66wyx/yuntong-roadshow/hardware/display-hy-a354tu102gg/README.md

# HY-A354TU102GG · 云瞳手持项目选定屏幕

更新：2026-11-03。状态：**用户已选定料号，结构与电气适配待验证**。本记录替代此前 AM200Q460460FLS1 和普通 3.5 英寸 320 × 480 屏的当前选型地位。

依据：用户提供的 [原始规格书](references/HY-A354TU102GG.pdf)，共 40 页。PDF 未经修改，以 Git LFS 保存。封面标记为 Preliminary、V1，修订表为 A0 / 2026-04-02；第 37 页内嵌结构图另有 2026-02-28 / Rev.02 标记。这不是已签核的最终承认书。

## 已核实的规格

| 项目 | 规格书记录 | 位置 |
|---|---|---|
| 厂家 | 深圳市华御智能电子有限公司 / Shenzhen Winfull Intelligent Electronics Co.,Ltd. | 封面 |
| 型号 | HY-A354TU102GG | 封面 |
| 尺寸 / 类型 | 3.54 英寸，AMOLED，LTPS，带 Oncell 触摸 | 第 5、15 页 |
| 分辨率 | **604 × 1024**，不是 640 × 1024 | 第 5、37 页 |
| AA 显示区 | **45.6624 × 77.4144 mm** | 第 5、37 页 |
| 像素间距 / 密度 | 75.6 μm；据此计算约 **336 ppi** | 第 5 页 / 计算 |
| 面板本体 | **47.56 ± 0.15 × 80.11 ± 0.15 mm** | 第 37 页 |
| 本体厚度 | **0.812 ± 0.15 mm**，不含保护膜 | 第 37 页 |
| 展平总包络 | 总表写 **47.56 × 118.07 × 0.812 mm**；结构图为 80.11 mm 面板 + 37.95 ± 0.5 mm 尾部 | 第 5、37 页 |
| 局部器件厚度 | 显示 FPC 器件区最大 1.45 mm；触摸器件区最大 1.05 mm | 第 37 页 |
| 圆角 | 结构图画出圆角轮廓；未标注可直接用于 CAD 的圆角半径或角部像素遮罩 | 第 37 页 |
| 显示驱动 | SD5207，COF | 第 5、37 页 |
| 触摸驱动 | CST3530；I2C 地址记为 0x5A、总线不高于 400 kHz，5 点触控依整机调试 | 第 14 页 |
| 显示接口 | **MIPI DSI**；lane 数存在冲突，不能据此释放原理图 | 第 5–7、12 页 |
| 模式 / 刷新 | Video mode；Normal 60 Hz、AOD 30 Hz | 第 13 页 |
| 亮度 | 典型 850 cd/m²，标称范围 765–935 cd/m²；以样品为准 | 第 17 页 |

## 对外观与 UI 的影响

1. **118.07 mm 不是刚性屏体高度。** 第 37 页注明 FPC 展平出货，本体高 80.11 mm。不能因此把掌上机直接拉长到 118 mm；也不能把带 COF/器件的排线任意折叠。折弯区域、半径、连接器位置、器件净空需厂家图纸与实物确认。
2. 现有 A1 的黑玻璃是 56.4 × 80.6 mm，A3 旧草案按另一块 55.5 × 84.96 mm 模组估算。新面板更窄，但 A1 玻璃高度与新面板本体只差 0.49 mm，不能当成已有装配余量。旧 82 × 86 / 82 × 90 mm 机身均只保留作比例参考；取得 FPC 折叠包络后再收敛壳体。
3. 保留用户的 CNC 铝框 / SLA 两种材质、正面可见铝边、底部 Type-C、内置 GNSS、平放雷达 / 竖持高度示意。面板圆角与机身三次贝塞尔圆角分别设计，不能相互代用。按键布局仍按最新确认记录推进，不因换屏自行新增触摸必选操作。
4. UI 改为 **604 × 1024 原生画布**。像素数约为旧 320 × 480 的 4.03 倍，但物理字号不会随分辨率自动变大；需要重新排版，不将旧界面非等比拉伸。雷达圆形保持圆形，中文字阶和线宽按毫米与实屏观察确定。
5. AMOLED 的黑底有利于显示区与黑色窗口融合，但仍有边缘结构。精确圆角 R、角部安全区和外观盖板须用厂家 DXF / STEP 与全白点亮样品核对。
6. 第 5 页写含 cover lens，但第 37 页的 0.812 mm 拆分为 POL、Encap、LTPS、泡棉铜箔，未清楚列出独立保护盖板。**不能直接把 0.812 mm 当成已含耐用外盖板的整套外观件厚度**，也不能未经确认重复叠加盖板。

## 对电气架构的影响

原 ESP32-S3 显示连接方案不能直接连接这块 MIPI DSI 面板。旧 A0 的 SPI/并口、15 pin 插座、LCD 恒流背光和 GPIO 表不适用于新屏；AMOLED 不使用该 LCD 背光电路。

**首版显示主控选全志 T113-S3，验证板选广州眺望 Core-T113-S3（S3/S4 系列手册的 134 针版本）。** 用户指定主控支持原生 4-lane MIPI DSI。核心板为 40 × 30 mm，手册表 3.2 和 §5.3.13 列出四通道显示输出及 D0–D3、CLK 差分对。实验室采用配套 T113-S-EVM 底板，通过自备适配板连接屏幕的 39 针接口。[核心板手册](https://17575419.s21i.faiusr.com/61/ABUIABA9GAAghOvnuAYovtOh7gc.pdf) · [评估套件与开发资料](https://www.talowe.com/modules/t113s.html)

适配板按核心板实际 DSI 信号核对五对差分线。手册 §5.3.13 将部分 CK / V2 网络名映射到数据 2 / 时钟功能，须逐对查评估板原理图。同步核对屏端针 10、38，屏幕电源与复位，触摸 I2C、中断及时序。按供货屏实测配置主机通道数，移植 SD5207 的 LP 初始化命令，验证 604 × 1024、60 Hz 显示及四角触摸。

便携版将核心板布置在定制载板上，为 1S 电池设计核心板所需的 5 V 供电路径，测量屏幕与接收器同时工作时的整机电流。T113-S3 负责显示与 UI，原 BLE、Wi-Fi RID 接收链路仍需单独验证，整机热设计与续航待测。

第 8 页给出的推荐工作电源：

| 电源域 | 最小 / 典型 / 最大 |
|---|---|
| VDDI | 1.65 / **1.8** / 1.95 V |
| VCI | 2.65 / **2.8** / 3.6 V |
| VBAT（面板 PMIC） | 2.9 / **3.7** / 4.5 V |

第 12 页包含上掉电时序，第 13 页含 LP 初始化命令；尚未据此实现驱动。复位、TE、触摸 IO 电平、关机反向供电、负载开关和整机功耗需要重新设计。PDF 没有足以计算续航的完整典型/峰值电流数据，不沿用旧屏续航估计。

## 厂家需澄清的问题

| 编号 | 资料中的问题 | 需要的确认 |
|---|---|---|
| D01 | 第 5 页标 2 lane，第 12 页标 4 lane，第 6、7、37 页引出 D0–D3 | 主控按四通道选型。取得实际供货屏对应的初始化代码、工作通道数、视频模式和时序，作为点屏输入。 |
| D02 | 第 6 页 pin 10 / 38 为 NC；第 37 页分别为 MTP_PWR / EN | 最终 39 pin 定义、NC/EN/MTP_PWR 处置与未使用数据 lane 的连接要求 |
| D03 | 第 5 页与第 37 页对本体/展平包络的口径不同；无精确圆角 R 与弯折规范 | 受控 DXF / STEP、AA 角部轮廓、推荐折叠形态、禁弯区、最小弯曲半径与公差 |
| D04 | 第 5 页称含 cover lens，结构图没有清晰的独立外盖板层 | 实际交货是否含外保护玻璃、材质、厚度、触摸叠层及可贴合区域 |
| D05 | 第 6 页推荐插座名称区分 ZIF / Finger；第 37 页仅写 OK-F302-39115 | 主板座完整订货号、触点面、FPC / 连接器封装图与样品 |
| D06 | VCI 典型 2.8 V，结构图标 3.3 V；触摸 IO 也有不同配置标注，缺功耗 | 实际交货电源配置、触摸 IO 电平、典型/峰值电流、亮度档位、关机漏电与上下电延时 |

卖家已表示可提供规格书和初始化代码，转接板需自行配套。样品调试资料可一次索取。

> 我们用四通道 MIPI DSI 主控，麻烦把 HY-A354TU102GG 这批屏的初始化代码发一下。如果有点亮时用的 lane 数、速率和视频时序，也请一起发过来。转接板我们自己配，做板前还需要核对 39 针接口中第 10、38 脚的接法，谢谢。

## 状态与资料来源

- 已完成：用户选型记录、PDF 原件归档、关键尺寸/引脚/时序页面核对、既有方案影响说明。
- 后续验证包括屏幕转接板、样品点亮、触摸驱动、FPC 装配、精确圆角、壳体和整机功耗。
- A1 / A2 模型和 A3 旧二维图继续作为历史参考，不冒充此屏的新结构模型。
- PDF SHA-256：`c0d59ce40a6809594c8275db5c50e692e292549ad8a2fcd617b4a81aef49ca24`。
