66wyx/yuntong-roadshow/hardware/rid-handheld-id-a3/README.md

# 云瞳 RID · ID-A3 外观包络

> 2026-11-03 更新：用户已选定 [HY-A354TU102GG](../display-hy-a354tu102gg/README.md)，3.54 英寸、604 × 1024 AMOLED、MIPI DSI。本文与两张 HTML 图按旧 320 × 480 矩形屏估算，保留为历史比例参考；其中屏幕尺寸、圆角遮光假设与壳体包络尚未按新屏重算。

日期：2026-10-30　状态：`appearance_envelope_only` — 不是加工图，不是 PCB/结构定型

本版回应两条已确认的输入：

1. 用户认可 **ID-A1 的比例**（82 × 86 × 20 mm，纵向黑玻璃，右列三键，橙色确认键）。
2. 屏幕转为 **3.5 英寸 320 × 480**，放弃 3.2 英寸 240 × 320 的 YDP320B006-V1。

[A1 / A2 原始资产](..)未改动。本目录只有图纸和说明。

- [ID-A3 尺寸包络](ID-A3-envelope.html)：A1 基准 / A3 包络 / 叠加 / 剖面 / 数值表。
- [ID-A3 正面外观](ID-A3-front.html)：真实 UI 按 320 × 480 排布，附 10–16 px 字阶校样。

## 1. 结论先说

**模组尺寸不约束外观比例。** 玻璃是嵌在前盖的遮光窗口里的，不透明前盖挡住模组边缘，所以决定观感的是一条丝印窗口，而不是模组外形。这一条把之前"3.5 英寸屏塞不进 A1 玻璃宽度"的死结解开了：

- 标准款 3.5 英寸模组宽 55.5 mm，A1 黑玻璃宽 56.4 mm，直接贴合只剩 0.45 mm，做不出窗口。
- 但玻璃可以比模组大。窗口做到 50.96 × 75.44，就足够罩住 48.96 × 73.44 的 AA，模组其余部分藏在前盖后腔。

于是不必去找那个查不到料号的 53.4 mm 窄边屏，标准款现货模组即可。

## 2. 尺寸

| 项目 | 数值 | 相对 A1 |
|---|---|---|
| 机身 | 82.0 × 90.0 × 20.0，R6.0 | 高度 +4.0，其余不变 |
| 盖板玻璃 | 56.4 × 84.3 × 0.8，R3.0 | 高度 +3.7，宽度不变 |
| 遮光窗口 | 50.96 × 75.44，R1.6 | 新增层 |
| 显示 AA | 48.96 × 73.44，320 × 480，约 166 ppi | 新增 |
| 模组 | 55.5 × 84.96 × 2.5（参考值） | 新增，待供应商图纸 |
| 右列控制区 | 22.8，摇杆 +7.5 / 确认 −13.4 / M −23.5 | 完全沿用 A1 |
| 玻璃中心 | x −10.0 / y 0.0 | 沿用 A1 |

玻璃占正面面积保持 93.7%，黑玻璃铺满正面的观感没有丢。正面玻璃比例从 1 : 1.429 变到 1 : 1.495，瘦长 4.6%，肉眼在正常距离下不易察觉。机身整体比例从 0.953 变到 0.911。

模组比玻璃高 0.66 mm、每侧窄 0.45 mm，全部藏在前盖 3.5 mm 厚的后腔里。

## 3. 为什么高度必须加

模组高 84.96，A1 玻璃高 80.6，差 4.36。前盖上下还要各留 2.85 的壁厚做窗口边框。所以总高 86 装不下，只能到 90。

如果坚持玻璃原封不动 56.4 × 80.6，机身照样得 90，但上下可见边会从 2.7 变成 4.7，黑玻璃看起来会松掉。所以选玻璃跟着长，保住 A1 的紧致感。

总高还有望压缩：模组上下非显示区合计 11.52 mm（上 5.52 / 下 6.0 左右，含 FPC 出线）。如果拿到实物确认 FPC 走下方且能折进中框，模组可下沉，总高有机会收到 89 甚至 88。

## 4. 结构分层

前盖 3.5（含玻璃嵌槽 0.8 与模组定位腔）、中框 13.0（CNC 6061，内藏主板与电池）、后盖 3.5。总厚 20.0 不变。

主板 1.6、电池 1S 厚 6.0（2000 mAh 目标）、Type-C 3.2 均为空间占位，不是定型器件。天线腔、屏蔽、散热都没有表现。

## 5. 圆角与 UI 安全区

这批 3.5 英寸面板**没有原生圆角**，四角是直角像素。R3 的圆角由盖板玻璃背面的遮光丝印做出来，会遮掉角部像素。因此窗口的 R1.6 之外，AA 内再留 4.0 mm 安全边距，实际可排版区域约 40.96 × 65.44。

## 6. 待确认

- 模组实物外形与 FPC 出线方向，决定总高能否收回 88–89。
- 上下 2.85 mm 前盖壁厚对 SLA 打印件是否足够，需开样。
- 320 × 480 / 166 ppi 下中文最小字号与雷达线宽，需实屏校字。
- Wi-Fi FPC 拟置后盖上缘非金属窗口；GNSS 陶瓷贴片位置与接地载板未定。
- 内外天线切换、按键数量（正面右列 vs 侧键）仍待用户冻结。
- 公差、装配、射频、热、续航均未验证。

## 7. 界面：无需重做

这是这轮最省事的一条。A1 的玻璃是 56.4 × 80.6，减去约 3 mm 边距，实际排版区约 50.4 × 74.6。A3 的 AA 是 48.96 × 73.44，**只差 3%**。原来的界面本来就按这个尺寸在排，不用重画。

密度 166 ppi，1 px ≈ 0.153 mm。大数字 40 px 约 6.1 mm 字高，正文 10–11 px 约 1.5–1.7 mm。字阶校样见 [ID-A3 正面外观](ID-A3-front.html) 第二节。

一处需要让步：A1 里 "广播估算 · 0.8 s · 右前方 17°" 这行在 166 ppi 下会贴到可读下限。它属于可牺牲的元信息，建议降为图标 + 单一数值，或改用英文缩写，别硬塞小字。

上下各 5.43 的丝印带不是废边，它承担了 A1 状态行的视觉重量，正好用上。

## 8. 文件

- `ID-A3-envelope.html`：毫米级尺寸包络图，含 A1 基准、A3 包络、叠加对比、剖面、数值表。
- 本文件。

A1 / A2 的 `.blend`、`.glb`、渲染、脚本全部保持原状。本版未接 Blender MCP，尚无 A3 的三维模型与照片级渲染；接入后再建 `RID_ID_A3_Studio` 场景，不覆盖旧场景。
