66wyx/yuntong-roadshow/docs/RID_EVT1_HARDWARE_BASELINE_2026-10-29.md

**云瞳掌上 RID 接收器 EVT1：直接整机验证基线**

2026-10-29。用户已确定从侧边实体键版直接开始验证，取消 CoreS3 过渡路线。EVT1 指第一轮工程样机，本文是首板设计输入；尚未生成已校核的原理图、PCB 或制造文件，也未进行无线、电源和续航实测。

本轮已形成 [EVT1-A0 工程包](../hardware/rid-handheld-evt1/README.md)：STEP/STL、尺寸与位置图、关键 BOM、GPIO 初表、UI 规格和主机核心测试。选型与实际验证状态以该包的 [工程评审](../hardware/rid-handheld-evt1/REVIEW.md) 为准。

按所选外观实施：近方形细砂灰机身，左侧黑色竖屏；右侧为上下摇杆、橙色确认键、正面 M 键；顶部电源键，底部 USB-C。用户已明确 USB-C 电池充电为首版必备功能，该口同时承担供电与 USB 数据。82 × 78 × 22 mm 是包络目标，最终外形需由实际器件和天线净空校核。首轮结构使用可拆卸的打印外壳，便于测量、检修与修改。

首板直接采用四层定制主载板，安装射频模组与传感器。以下是设计选型，不等于已经形成可下单的完整 BOM。

| 器件/部件 | 数量 | 用途与状态 |
|---|---:|---|
| ESP32-S3-WROOM-1U-N16R8 | 1 | UI、BLE、消息汇聚；主控基线 |
| ESP32-C5-WROOM-1U-N8R8 模组 | 2 | 分别进行 2.4 GHz 与 5.8 GHz Wi-Fi 接收；采购与实机能力核定后冻结 |
| MAX-M10S | 1 | 本机 GNSS 位置与授时；独立天线 |
| BMI270 | 1 | 六轴 IMU，用于姿态和运动检测 |
| BMM350 | 1 | 三轴磁力计，用于校准后绝对方向与异常检测 |
| Displaytech DT024ETFT-IPS，240 × 320 | 1 | ILI9341，42.52 × 59.86 × 2.40 mm；SPI 接口选择表冲突及 FPC 折回待厂家/样品确认 |
| 单节锂电池，约 2,000 mAh | 1 | 形状、厚度与最大电流按结构及功耗验证确定 |
| BQ25619RTWR | 1 | 充电与系统供电路径候选；支持读回充电状态，外围与热设计待完成 |
| TPS63070、TUSB320LAI、MAX17048 | 各 1 | 主稳压、Type-C CC/电流识别、电量检测；另需独立保持/关断电路与各电压域设计 |
| 壳内天线、同轴线、连接器 | 按射频设计 | BLE、两路 Wi-Fi 与 GNSS 的独立路径；具体料号和布置待验证 |
| 实体键、屏幕 FPC、USB-C、测试点 | 按结构设计 | 与所选正面布局对应 |

1U 表示模组采用外接天线路径；本机把天线放在外壳内部，通过短同轴连接。并非要求机身伸出天线。天线数量、净空、隔离和握持损耗必须在布局阶段与接收测试中核对。

[S3 模组官方资料](https://documentation.espressif.com/esp32-s3-wroom-1_wroom-1u_datasheet_en.html)支持上述存储配置与天线版本；[C5 模组资料](https://documentation.espressif.com/esp32-c5-wroom-1_wroom-1u_datasheet_en.html)说明其双频与外接天线版本。[BMM350 官方资料](https://www.bosch-sensortec.com/en/products/motion-sensors/magnetometers/bmm350)用于确认地磁传感器接口和驱动需求。[BQ25619 官方资料](https://www.ti.com/product/BQ25619)用于候选充电电源路径设计。所有元件需按最终订货号的数据手册、参考电路和封装图实施。

接口先按功能分配，[GPIO 初表](../hardware/rid-handheld-evt1/electrical/gpio.csv) 已形成，待原理图校核后冻结。

| 主控连接 | 外设 | 首板要求 |
|---|---|---|
| SPI | LCD | 预留 CS、DC、RESET、背光控制；FPC 方向与屏幕外形一致 |
| UART A | 2.4 GHz C5 | 双向数据、独立 EN/复位/下载测试点 |
| UART B | 5.8 GHz C5 | 双向数据、独立 EN/复位/下载测试点 |
| I2C | MAX-M10S、BMI270、BMM350、电量计 | 核对地址、电压、上拉与总线负载；条件不合适时分总线 |
| GPIO/中断 | GNSS PPS、IMU 与按键 | 标定传感器轴向，验证消抖和姿态切换 |
| USB-C | 5 V 受电/电池充电、S3 原生 USB 数据 | 同一接口实现充电、供电、下载、调试和观测导出；独立保留 UART 恢复入口 |

LCD、存储、USB、启动配置与调试功能的引脚冲突在原理图阶段逐项检查。当前不把概念接口表当作可直接布线的 GPIO 表。两颗 C5 的分路电源应通过合适的负载开关/供电设计控制，GPIO 只提供控制信号，不直接给射频模组供电。

电源结构为 USB-C/受保护电池 → 充电与系统电源路径 → 3.3 V 稳压及分路供电。USB-C 受电端的 CC 配置、输入限流与充电电流需结合实际可获得电流设置。首轮上电使用可限流电源；保留整机、各 C5、显示背光和 GNSS 支路的电流测量位置。

USB-C 充电要求固定为：支持 A-to-C 与 C-to-C 线材，以及插头正反插；首版按 5 V 受电设计，输入电流识别与限流在电源原理图中明确。支持开机边充边用和关机充电；运行中插拔充电线，正常电池状态下接收与记录连续。UI 显示电池百分比及充电/充满/异常状态，关机时保留充电状态指示。电池保护、温度监测、充电终止及输入保护随充电方案一起设计，充电电流按电芯规格、输入预算和实测温升确定。

首板专门验证 USB-C 正反插、A-to-C/C-to-C 兼容性、关机充电、边充边用、充满结束、低电及充电线插拔。充电与最高背光、三路接收同时开启时，记录供电波动、温升和定位/接收状态；UI 的充电图标必须由实际充电状态驱动。

候选充电芯片的存在不等于已实现整机开关机。首板必须另行定义硬件锁存/负载开关：电源键唤醒后由主控维持供电，正常关机先保存状态再切断主负载，并保留必要的硬件恢复方式。息屏只关闭显示，接收和记录可继续。

结构校核先于载板尺寸冻结。用屏幕供应商外形图确认可视区域、黑边、FPC 弯折及背光厚度；为 GNSS 天线、各无线天线、电池保护和公差分配实际空间；再确定载板外形、螺柱、按键行程和壳体厚度。不得用屏幕对角线代替屏幕模组尺寸，也不得把天线净空算成可堆叠电池的空间。

同一台首板按下列顺序验证。

| 顺序 | 工作 | 通过后才进入的下一步 |
|---|---|---|
| 1 | 限流上电、短路与电压、USB 下载、串口、Flash/PSRAM、复位恢复 | 主控稳定运行 |
| 2 | 目标屏幕、背光、上下/确认/M/电源键，回放数据驱动两种视图 | UI 与实体按键符合选定版本；演示状态明确 |
| 3 | GNSS、IMU、磁力计单独与组合工作 | 自身定位有效、整机罗盘校准、持握切换与方向轴正确 |
| 4 | BLE、2.4 GHz Wi-Fi、5.8 GHz Wi-Fi 各自接收 | 独立已知样本解码与原始记录对照，列明未测协议/PHY |
| 5 | 三路同时接收，并改变背光、USB 充电、姿态和握持 | 能量、时延、漏包、GNSS 与罗盘干扰有记录 |
| 6 | 装入目标外壳，在平放与竖持状态做路线、续航与异常恢复测试 | 得到接收覆盖、续航、定位质量和结构修改清单 |

这里的逐项验证发生在同一块定制板上，不改变硬件平台。软件回放用于界面与接口验证，真实接收用于无线验证，两种结果分别记录。

首轮优先验证三类风险：三路接收与显示是否能并行稳定工作；安装后的 GNSS/罗盘是否在两种持握姿态都可用；目标外形是否容纳电池、按键及天线并达到可接受的功耗。约 3 小时续航、外形与覆盖指标都应在实测后再确定。

设计文件按顺序形成：屏幕/电池/天线料号及外形资料、正面与堆叠控制图、带订货号的 BOM、原理图与 GPIO 分配表、布局与射频检查记录、首板制造包和测试记录。制造包以完成校核的工程文件生成；当前仍处于设计输入阶段。
