66wyx/yuntong-roadshow/docs/RID_HANDHELD_DESIGN_V2_2026-10-29.md

**云瞳掌上 RID 接收器：硬件、结构与交互讨论稿 V2**

后续更新：[ID-A1 外观设计](../hardware/rid-handheld-id-a1/README.md)采用 CNC 铝合金中框、3D 打印前后盖，并按用户要求将参考图外观优先。以下 A0 尺寸、2.4 英寸屏幕和侧壁天线布局不再作为外观冻结条件。

2026-10-29 更新：用户确定直接从侧边实体键版本开展首台整机验证，采用定制主板，不使用 CoreS3 过渡验证。内置 GNSS，平放显示雷达式俯视，竖持显示目标高度示意。本文替代初稿中便携版的手机尺寸、3.5 英寸屏幕、大电池及 GNSS 可选配置；首板实现按 [EVT1 硬件基线](RID_EVT1_HARDWARE_BASELINE_2026-10-29.md)执行。尺寸和续航仍为设计目标，尚未完成 PCB 布局和实机测试。

外观按用户选定图：82 × 78 × 22 mm 为布局目标，2.4 英寸 240 × 320 竖屏置左，上下摇杆、橙色确认键和 M 键均在正面右侧，顶部为电源键。采用细砂灰色 PC/ABS、黑色屏幕盖板和橙色确认键。背面稍微鼓起并做防滑区，顶部设置壳内天线区域，底部设置 USB-C 和挂绳孔。最终尺寸需由屏幕外形、载板、电池和天线堆叠校核，不能仅缩放示意图。

**第一轮直接做定制验证主板 EVT1。** 采用带 Flash/PSRAM 的 S3 射频模组、两颗 C5 模组、独立 GNSS、IMU 与磁力计，配置目标尺寸的屏幕和实体按键。验证板就安装到该外观的结构样机中；电源、显示、传感器与无线接收分阶段上电调试。

将屏幕、按键、电源与传感器直接布置到定制载板和目标外壳中。首板器件基线如下；完整生产 BOM 仍需补齐屏幕、天线、电源外围和连接器料号。

| 功能 | 首板基线 | 实现要求 |
|---|---|---|
| UI/BLE 主控 | ESP32-S3-WROOM-1U-N16R8 | 16 MB Flash / 8 MB PSRAM；壳内天线 |
| Wi-Fi 接收 | ESP32-C5-WROOM-1U 模组 ×2 | 分别承担 2.4 GHz 与 5.8 GHz，独立复位/下载；具体存储后缀在采购前核定 |
| GNSS | MAX-M10S | 独立 GNSS 天线和射频路径，接收器自身定位 |
| 姿态 | BMI270 | 六轴 IMU，安装方向与机身坐标标定 |
| 地磁方向 | BMM350 | 三轴磁力计，整机校准、倾斜补偿与磁场异常处理 |
| 显示 | Displaytech DT024ETFT-IPS、240 × 320 | ILI9341；外形已用于 A0 建模，接口表与 FPC 仍待确认 |
| 电池 | 约 2,000 mAh 单节锂电池 | 含保护、电量检测、边充边用电源路径及充电限流 |
| USB-C 充电 | 底部单接口，首版必备 | 充电/供电/USB 数据共口；支持开机边充边用、关机充电，显示充电状态 |
| 通知 | 充电状态灯；声音提示另行设计 | A0 未包含蜂鸣器或声学开孔，需在原理图和 IO 扩展评审后落实 |

[MAX-M10S 官方数据手册](https://content.u-blox.com/sites/default/files/MAX-M10S_DataSheet_UBX-20035208.pdf)给出的模组典型尺寸为 9.7 × 10.1 × 2.5 mm；这是接收模组尺寸，不包含天线和净空。双 C5 继续沿用初稿的接收分工，每颗仍一次监听一个信道；S3 的 BLE 还需验证不同 PHY 扫描。三路接收、屏幕和 GNSS 同时工作时的漏包、功耗及干扰需要实测。

接口按两路 UART 接 C5、I2C 接 GNSS/IMU/磁力计、SPI 接屏幕规划，并给 GNSS 单独引出 PPS 和维护串口测试点。具体 GPIO 在原理图中对照模组的数据手册分配，排除 Flash/PSRAM 占用、USB、启动配置等冲突。S3、两颗 C5 均保留独立下载与复位测试点，避免一颗固件异常时整机无法诊断。

**结构优先为天线和罗盘保留空间。** 顶部设置非金属 GNSS 天线窗口，Wi-Fi/BLE 天线与 GNSS、屏幕排线、充电转换器保持经过测试的隔离。金属质感通过塑料表面处理实现，不做整圈金属包壳。GNSS 模组并不是越靠近屏幕越好，磁力计也要避开电池大电流回路、磁性扣件和扬声器。最终器件位置取决于射频与电磁兼容测试，不能用外观示意图直接代替 PCB 布局。

从前到后可按盖板/薄屏、主载板、后层电池、后壳构建。电池和主板可以局部错位，天线净空区不塞电池；屏幕与电池应有足够的机械保护和装配公差。给 GNSS 天线分配实际体积、接地和射频布线空间，22 mm 厚度先通过堆叠剖面验证。若采用陶瓷贴片天线，应分别测试平放、竖持、握持遮挡时的定位表现；不能假定竖持仍有和平放一样的定位质量。

2,000 mAh、3.7 V 电池对应约 7.4 Wh。按平均功耗 2 W、可用能量 85% 的假设估算，可运行约 3.1 小时。因此将连续接收约 3 小时作为紧凑版的首轮设计目标；背光、射频和转换损耗测完后再确定续航，不能沿用初稿大电池的 4–6 小时目标。

**四类输入分别承担不同职责。** GNSS 给出接收器自身的位置与时间；加速度计和陀螺仪给出设备倾角；磁力计配合姿态估算静止时的朝向；RID 报文给出航空器上报的位置与高度。普通单天线 GNSS 的运动航迹角不能替代静止设备朝向，六轴 IMU 也不能长期独立确定绝对航向。

在统一坐标和高度基准后，由航空器与本机位置计算 ENU 相对向量、水平距离、真北方位角、相对高度和仰角。电子罗盘完成整机校准、倾斜补偿及磁偏角处理后，用于机头朝上视图。平放以机身上边缘的水平投影为朝向；竖持以屏幕背面法线的水平投影为朝向，中间过渡采用四元数和连续性约束。接近竖直时不能继续简单沿用“顶部边缘的水平投影”，否则会出现投影退化。交互示意使用给定模拟朝向，真实传感器轴变换仍需在固件台架验证。

**两种显示模式建议如下。**

| 持握/模式 | 主视图 | 主要信息 | 操作 |
|---|---|---|---|
| 平放 | 以自身为中心的雷达式俯视图，距离圈 50/100/250/500 m 等可选 | 方位、水平距离、选定目标、位置年龄 | 上下切换目标，确认键选定跟随 |
| 竖持 | 线框地面、目标投影和高度柱组成的 2.5D 示意 | 相对高度、水平距离、仰角、估算状态 | 保留同一选定目标；可切回俯视 |
| 手动固定 | 固定雷达式俯视或高度示意 | 保留模式标识 | M 键切换自动/雷达/高度 |
| 数据不足 | 可用的信息与原因提示 | GNSS 未定位、罗盘受扰、高度未知、位置陈旧 | 不用假的方向、高度或距离补齐显示 |

竖持图是对已接收到坐标的空间重绘，不是设备新测得了飞机高度。若视觉表达放大了高度轴，应直接标注倍率。选择线框 2.5D 可降低遮挡，方便小屏查看，也适合 S3 上实现。

自动模式可先采用以下待调试参数：屏幕相对水平面的夹角低于 25°并稳定 600 ms 切俯视；高于 60°并稳定 600 ms 切高度；25°–60°维持上一视图。检测明显运动时暂缓切换。模式切换不重置目标和距离档位。固件允许手动固定视图；接近目标只显示提示，不必强制切换。

用户在附近时通常更需要看高度，但不应因距离小于一个固定数字就跳转页面。可以先以约 100 m 做可配置的提示区间，结合设备是否竖持决定显示；近距离 GNSS 误差也可能导致方位波动，界面应保留可靠性与数据年龄。

按键建议保留清晰、稳定的分工。

| 按键 | 主页面 | 菜单/详情 | 物理设计 |
|---|---|---|---|
| ▲ / ▼ 摇杆 | 上/下一个目标 | 上/下移动选项 | 两个独立触点，靠形状区分，凸起便于盲按 |
| 橙色 ✓ | 选定/取消跟随当前目标 | 确认选项 | 圆形、与上下键留间距，避免握持误触 |
| M/返回 | 短按循环自动/雷达/高度；长按约 1 s 打开设置 | 短按返回上一层，长按回总览 | 按用户选定图固定在正面右侧、确认键下方 |
| 电源 | 长按开关机；短按息屏/唤醒 | 同主页面 | 凹入或侧边保护；息屏继续接收，关机清楚提示 |

正面按键布局以用户选定图为准。设备电源键位于顶部，其长按行为结合最终电源管理电路实现；复位与下载按键采用内部测试点，不占用日常操作区。

视觉方向延续参考图的黑色面板、细砂外壳、橙色动作键。主视图不堆完整身份信息；状态栏只显示 GNSS/方向有效性、接收状态与电量，下方保留选定目标、距离、相对高度、更新时间。橙色始终表示当前选定目标和确认动作，其他目标低对比显示；异常同时用文字说明。

默认机头朝上时显示 N 指示；磁场异常切换北向上并提示，不能继续让错误箭头随手转动。自身定位无效时只展示广播身份和原始坐标，暂停相对距离与方位。目标或本机高度无效、基准不一致时，相对高度与仰角显示“—”；切换竖持不补一个估计数字。广播的相对起飞高度不能直接当成目标相对接收器高度。

实验室内 GNSS 可能无法正常定位。可把匹配天线放到有良好天空视野的位置，并单独验证安装后性能；使用回放或软件场景时，所有页面均明确标记为演示数据。下一轮硬件冻结前应完成：两种持握姿态下的 GNSS 和罗盘测试、三路同时接收测试、整机功耗测试、屏幕可读性、按键误触及壳体尺寸剖面评审。
