66wyx/yuntong-roadshow/hardware/rid-handheld-evt1/REVIEW.md

**云瞳 RID · EVT1-A0 工程评审 · 2026-10-29**

直接采用定制 ESP32-S3 主板、双 ESP32-C5、内置 GNSS/IMU/磁力计、左侧 2.4 英寸屏、右侧上下键/橙色 ✓/M、顶部电源键、底部 USB-C，取消 CoreS3 路线。

本版完成了可复现的结构包络与拆件、尺寸/位置控制图、关键订货号清单、29 项 GPIO 初表、按键/UI 规格和固件起步工程。机身名义尺寸 82 × 76 × 21 mm，含按键目标包络 82 × 78 × 22 mm。电池约 2,000 mAh 是设计目标，续航尚未实测。

| 检查 | 实际结果 | 范围 |
|---|---|---|
| 原生 C++17 逻辑 | 19 项通过；`-Wall -Wextra -Werror` | 姿态切换、WGS84 相对位置、未知/过期数据、朝向退化、充电状态与串口 CRC/重同步 |
| GPIO | 29 项，无重复，避开所列启动/八线存储占用脚 | 不是引脚电气/ERC |
| CAD 几何 | 29 个有效实体；已建模刚性部件名义交叠为 0 | 不是完整公差、线束或柔性排线装配验证 |
| STEP 回读 | 29 个有效实体 | 验证导出可读及实体数量 |
| STL 网格 | 7 个结构试装件，无边界/非流形边 | 前壳、后壳、屏幕托架、四颗前键；顶键暂为占位 |
| GLB | v2，29 个网格 | 可视化容器检查 |
| ESP-IDF 构建、实物电源/射频/续航 | 未执行 | 当前没有 IDF 工具链与样机 |
| 原理图/ERC、PCB 走线/DRC | 未完成 | 当前主板是尺寸包络，不能据此打板 |

结构采用前后两片壳体、四角螺柱、主板和后层电池、独立屏幕托架与分体按键。上下两键组成长形外观，分别触发独立开关。前壳打印方向与键帽方向已在 STL 中调整并平移到 Z=0；仍需选择材料、支撑、打印补偿并试装。

当前名义间隙：电池到 PCB 为 0.6 mm；S3/C5 顶部到 LCD 背部为 2.9 mm；GNSS 陶瓷贴片到前壳内顶为 0.8 mm。它们没有扣除所有胶层、载板、供应商公差和电池鼓胀，不能视为足够的量产余量。模型中不含完整 GNSS 载板、同轴线、实际 USB 座、所有电源元件、紧固件、卡扣、挂绳孔及密封件。

需要首先解决的三项：

1. **屏幕。** 已按 Displaytech DT024ETFT-IPS 外形建模，而不是按 2.4 英寸对角线猜尺寸。供应商 PDF 的 IM0/IM1 表与 SPI 描述存在不一致，必须确认；20 mm FPC 尾部需要折回，已留 15 × 20 × 2.68 mm 空间并开托架通道，但折弯区/元件位置/连接器朝向尚未验证。电气需要约 2.8 V 电源域、信号电平核对及恒流背光升压。
2. **电池。** 按含保护、NTC、绝缘及出线的 52 × 64 × 6.5 mm 最大包络设计。没有将 LP605060 当成唯一完整电池型号；供应商最大尺寸、鼓胀量、充放电能力和连接器需给出后再冻结。若超出余量，优先调整厚度，不挤压电池。
3. **天线与电源。** GNSS 贴片的地平面/载板和三条内置 FPC 的净空、馈线、耦合、握持损耗未验证。主电源的启动/瞬态/热预算、USB 默认电流、硬件保持与关机反灌也需要完整电路和实测。

USB-C 已进入架构与验收要求：正反插、A-to-C/C-to-C、5 V 受电、充电与数据共口、边充边用、关机充电。BQ25619 负责充电与电源路径；TUSB320LAI 负责 CC/输入电流识别；MAX17048 负责 SOC；主负载独立关闭。当前只有候选与状态解释逻辑，尚不是已验证的充电电路。

固件核心可以运行主机测试；S3/C5 是 ESP-IDF 起步工程，默认不启用未经审查的板级输出和 C5 接收。C5 已写入被动 Beacon/Probe Response 信息元素筛选及 UART 输出路径，尚未在目标 SDK 编译或实板验证；NAN、BLE 接收、国际/国标业务解码和硬件驱动未实现。UI 图片为演示，固件不会拿这些数值当成真实遥测。

后续顺序：供应商三项尺寸/接口核查 → 完整原理图与电源计算/ERC → 主板与射频布局/DRC → 首板与打印件装配 → 按 `validation/BRINGUP.md` 留下原始测试记录 → 修订 EVT1-A1。现有 OpenDroneID、国标兼容与系统部署路线仍见项目根目录 `docs/RID_RECEIVER_PLAN_2026-10-29.md`，本包聚焦掌上版首台工程。
