66wyx/yuntong-roadshow/hardware/rid-handheld-id-a2/DESIGN_NOTES.md

# ID-A2 设计输入与复核记录

日期：2026-10-30。以本轮用户选择的 AM200Q460460FLS1、铝壳包围正面和三次贝塞尔四角为准。A1 的 82 × 86 × 20 mm 三段包夹结构退出当前外观。

## 材质与结构

侧壁与正面金属围边建为一个 CNC 铝壳实体；手掌握住侧边、手指经过四角和正面周缘时接触铝件。前面板为内嵌打印件，装在金属唇边以内，下沉 0.35 mm；背部打印盖也装在铝壁内部。装配缝藏在内周边，不再沿侧壁形成上下两条分层带。

前面板设计有内侧窄定位翻边。为讨论从后部装入的路径，翻边包络设为 59.8 × 49.8 mm，铝壳内腔设为 60.4 × 50.4 mm。尚未设计螺柱、扣位、装配顺序细节及工艺公差。后盖四枚内沉螺钉和握持细槽为 ID 提案。

| 参数 | 当前外观值 / mm | 说明 |
|---|---:|---|
| 机身外包络 | 64 × 54 × 20 | 不含按键突出；目标尺寸，非装配冻结 |
| 外轮廓角部过渡长度 L | 9.2 | 沿直边的过渡长度，不是圆弧半径 R |
| 前方铝壳开口 | 58.2 × 48.2，L = 6.3 | 正面直边金属宽 2.9 |
| 打印前面板可见部分 | 57.7 × 47.7，L = 6.05 | 平直段单边缝隙约 0.25 |
| 打印后盖 | 60 × 50，L = 7.2 | 嵌在铝外壳内，下沉约 0.30 |
| 前面板 / 金属顶面 Z | 9.65 / 10.00 | 下沉 0.35 |
| 上下键整体宽 / 高 | 10.4 / 17.9 | 两个独立键帽，中间留缝 |
| 橙色确认键直径 | 10.5 | 外周双环与 80 条细刻纹 |
| M 键 | 7.5 × 3.3 | 低于上下键与确认键 |
| Type-C 外壳开口 | 11.4 × 4.8 | 接口壳体约 9.0 × 3.3，插头外包络待验证 |
| 顶部电源键 | 8.6 × 2.6 | 移到顶边平直段，避免跨入曲率过渡区 |

自然银铝壳采用细喷砂阳极氧化视觉目标，边缘细亮边；打印件保留温灰色细哑光感。没有把打印件虚构成金属件。颜色和粗糙度为渲染提案，量产 CMF 需实际色板确认。

## 四角的三次贝塞尔定义

每个 90° 角用两段三次贝塞尔组成。以进入上方直边处为原点，X 朝右、Y 朝下，按角部长度 L 归一化：

```
第一段：P0=(0,0), P1=(0.28L,0), P2=(0.64L,0), P3=(0.82L,0.18L)
第二段：Q0=P3, Q1=(L,0.36L), Q2=(L,0.72L), Q3=(L,L)
```

首尾相邻的三个控制点分别共线，曲率在直边连接处为零；两段中间的位置、一阶导数和二阶导数相等。其余三角通过镜像生成。这样可实现与直线的 G2 连接及两段曲线间 C2 连接。外框与内框采用相同构造，角部金属宽度略有变化，并非严格等距偏移。

参数以用户要求的 iPhone 直板机视觉为参考自主构造，没有声称测绘、取得或复用苹果的官方外形曲线。0.25 mm 的边缘柔化是截面处理，与平面内的贝塞尔角部曲线分开设置。

Blender 保留 `RID_A2_Cubic_corner_control_path` 精确控制柄；实体轮廓按每段 32 步采样。主要实体的封闭性和曲线导数误差记录在 `geometry-review.json`。SVG 保留精确 cubic path，方便后续 CAD 曲线重建。

## 屏幕与玻璃

采用供应商 [AM200Q460460FLS1 文件目录](https://github.com/osptek/display-amoled-2inch-460x460/tree/main/versions/AM200Q460460FLS1)及[原始 PDF](https://raw.githubusercontent.com/osptek/display-amoled-2inch-460x460/main/versions/AM200Q460460FLS1/datasheets/AM200Q460460FLS1.pdf)。本地归档 `references/AM200Q460460FLS1.pdf`，SHA256 为 `b471a0d875ba527e4f36e73cbc4f9bb25befbb610ba8fec889620960f60d65e2`。

| 资料项目 | 值 | 模型处理 |
|---|---|---|
| 分辨率 / 接口 | 460 × 460 / QSPI | 两张 460 × 460 原生 DEMO 贴图 |
| 有效显示区 AA | 35.88 × 35.88 mm | 不拉伸；仅显示区发光 |
| 下层 CG 外包络 | 38.50 × 39.20 mm | 定位于面板后方，保留下台阶 |
| 上层 CG 台阶 | 36.50 × 36.50 mm | 独立的玻璃上层实体 |
| CG 两层厚度 | 0.50 + 0.80 mm | 分层建立；玻璃顶面 Z=9.90 mm |
| 模组总厚度 | 表格 2.28 mm；图纸 2.26 ± 0.20 mm | 外观包络用 2.28，内部应预留到约 2.48 mm 并核对实物 |
| FPC | 图纸注明折弯出货 | 仅示意折返到屏幕后方；弯折半径、元件高度、连接器位置待确认 |

尺寸表在 PDF 第 3 页、机械图在第 4 页（按文件物理页顺序）。图纸 VA 与表格 VA 有小差异，未作为冻结切口尺寸；玻璃小圆角也需实物/2D CAD 最终核对。供应商 README 触控栏与图纸触控 IC 信息不一致，本轮不依赖触控能力。不得混用先前 AM200MT460460FLS2 的 MIPI 图纸。

## 按键和界面提案

| 操作 | 行为提案 |
|---|---|
| ↑ / ↓ 短按 | 切换目标；菜单内上下移动 |
| 橙色 ✓ 短按 | 选定 / 取消选定目标；菜单内确认 |
| M 短按 | 打开视图菜单，选择自动 / 雷达 / 高度示意 |
| M 长按 | 返回主画面 |
| 电源长按 | 开关机，具体时长由电源管理方案确定 |
| 电源短按 | 熄屏 / 唤醒，继续接收的行为待功耗评估 |

屏幕适配采用大图形、两项主读数、底部目标与数据年龄。平放展示雷达视图，竖持展示高度示意；自动切换需滞回和停留时间，避免手抖反复切换。当前两张图均标记 DEMO，显示 168 m、相对高度约 +62 m、右前方 17° 是示例数据。

高度图只能使用明确高度基准的广播值与本机定位信息；高度基准未知、位置无效、航向未校准或目标过期时，应显示未知/失效状态，不能生成看似准确的空间位置。此条是 UI 行为约束，本版尚未实现传感器与协议软件。

## 下一轮装配输入

外观确认后，核对实物屏幕和完整 FPC，装入电池、PCB、Type-C 充电接口与 GNSS 天线。正反打印区可作为天线窗口候选，但连续铝壳仍可能遮挡或失谐；需要重新做位置、净空和射频验证。不能沿用 A0 金属中框方案下的天线位置。当前未计算续航、接收距离或防水等级。

所有外形、字标、背盖与玻璃台阶为外观评审资产；没有发布 STEP 工程实体、CNC 刀路或可直接下单加工的公差图。
