66wyx/yuntong-roadshow/hardware/rid-handheld-evt1/interface/height-demo.png

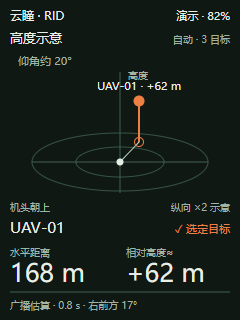
hardware/rid-handheld-evt1/interface/height-demo.png
