66wyx/yuntong-roadshow/hardware/rid-handheld-evt1/interface/radar-demo.png

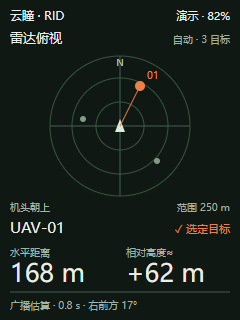
hardware/rid-handheld-evt1/interface/radar-demo.png
