66wyx/yuntong-roadshow/hardware/rid-handheld-evt1/mechanical/generated/exploded-view.png

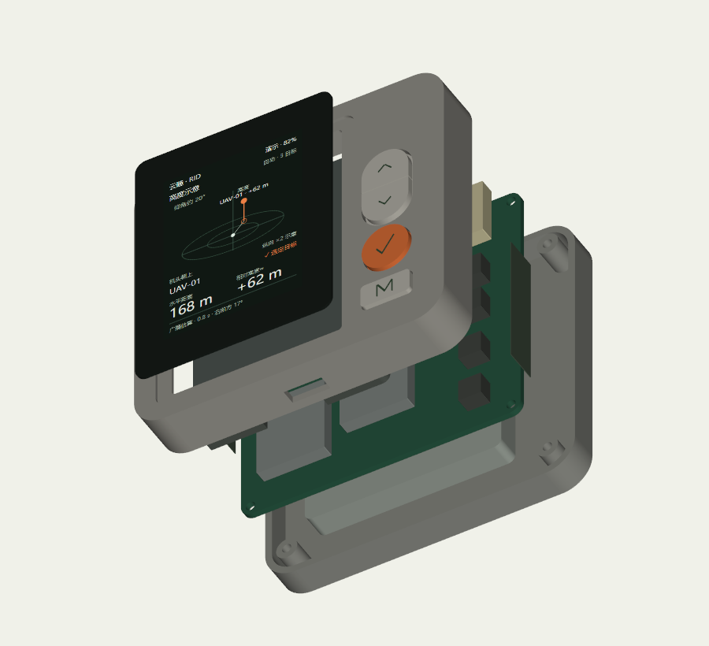
hardware/rid-handheld-evt1/mechanical/generated/exploded-view.png
