66wyx/yuntong-roadshow/hardware/rid-handheld-evt1/mechanical/generated/front-dimensions.png

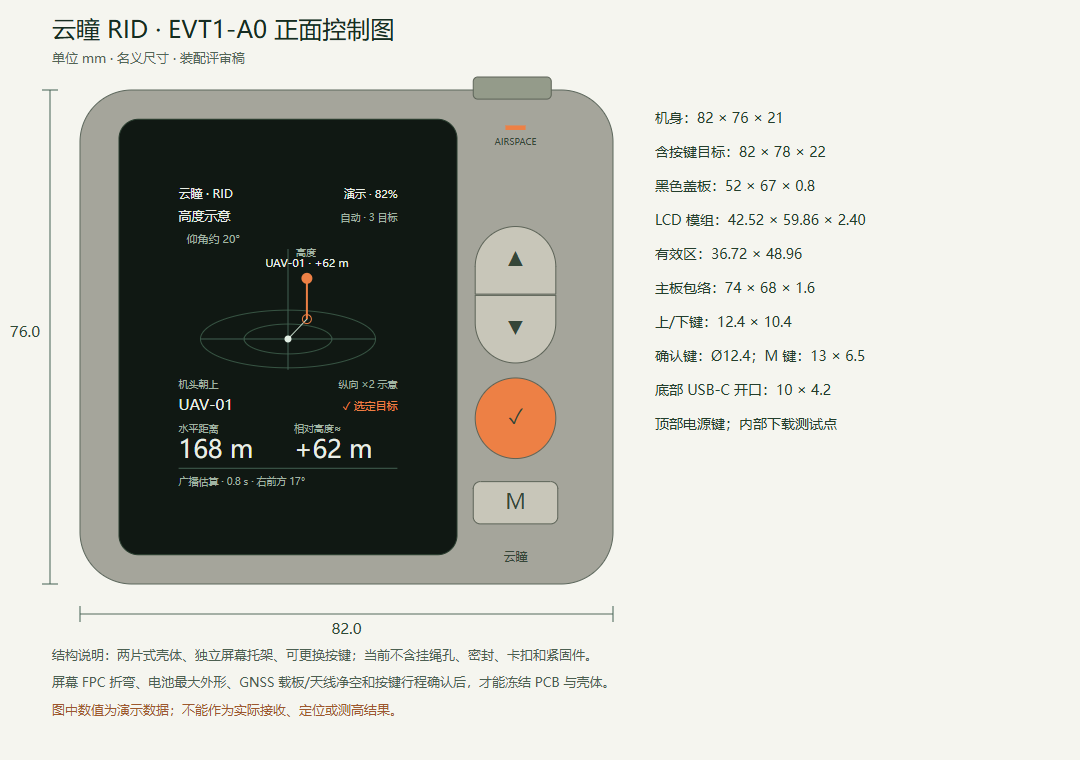
hardware/rid-handheld-evt1/mechanical/generated/front-dimensions.png
