66wyx/yuntong-roadshow/hardware/rid-handheld-evt1/mechanical/generated/stack-dimensions.png

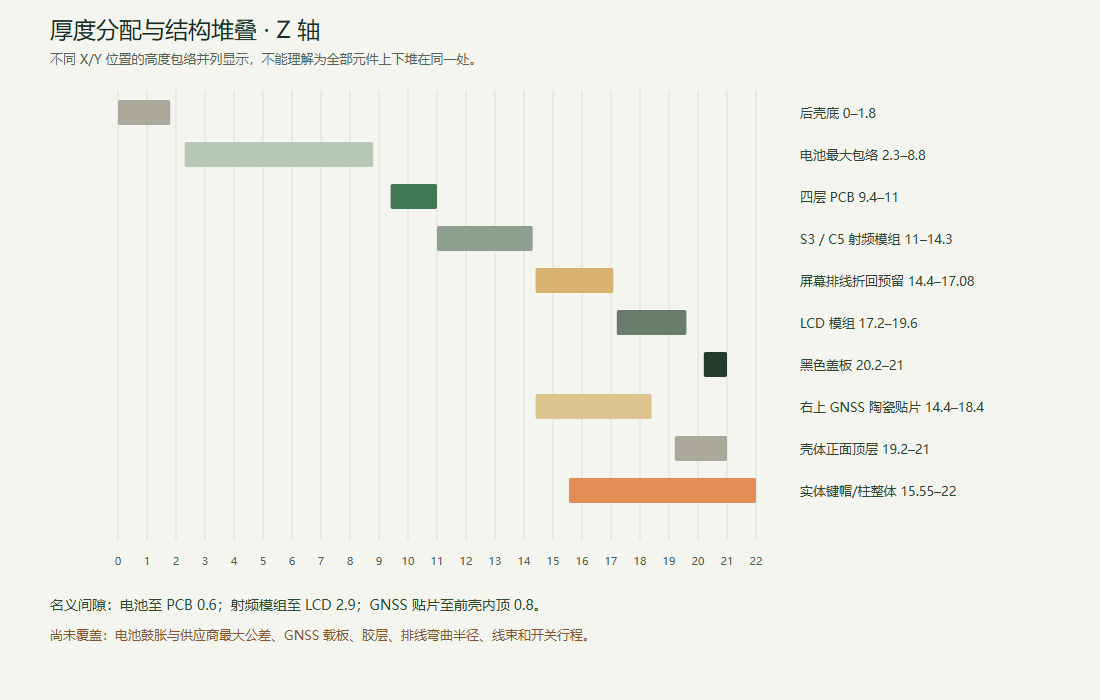
hardware/rid-handheld-evt1/mechanical/generated/stack-dimensions.png
