66wyx/yuntong-roadshow/hardware/rid-handheld-id-a1/assets/reference-rid-layout.png

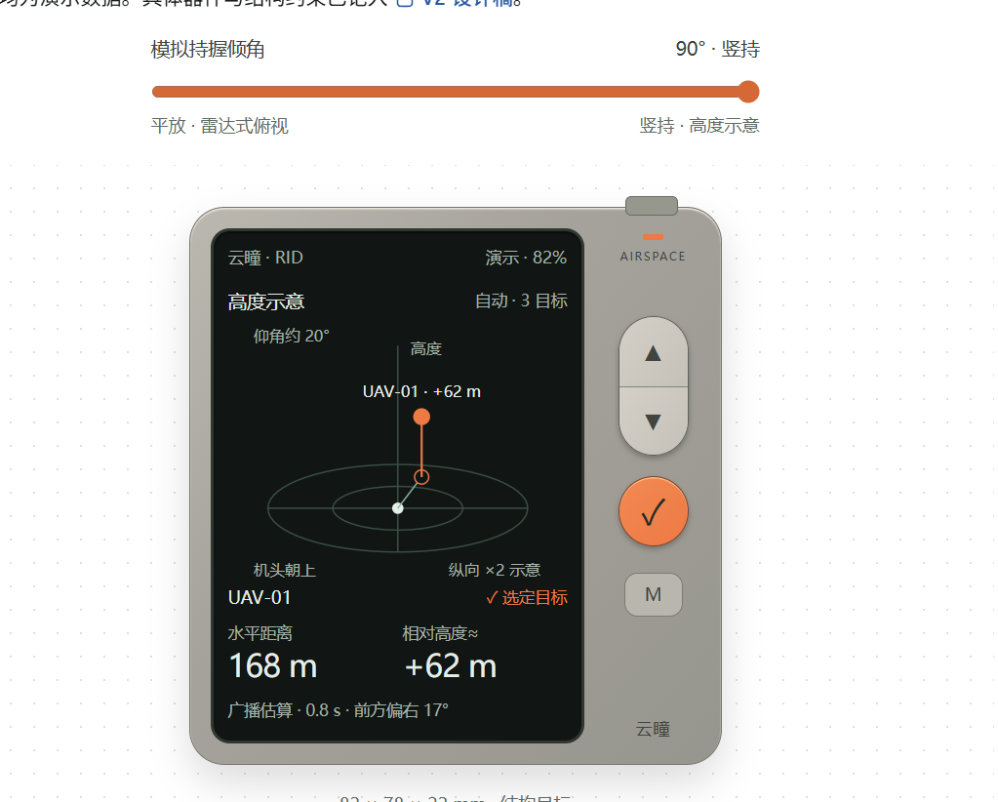
hardware/rid-handheld-id-a1/assets/reference-rid-layout.png
