66wyx/yuntong-roadshow/hardware/rid-handheld-id-a1/assets/screen-height.png

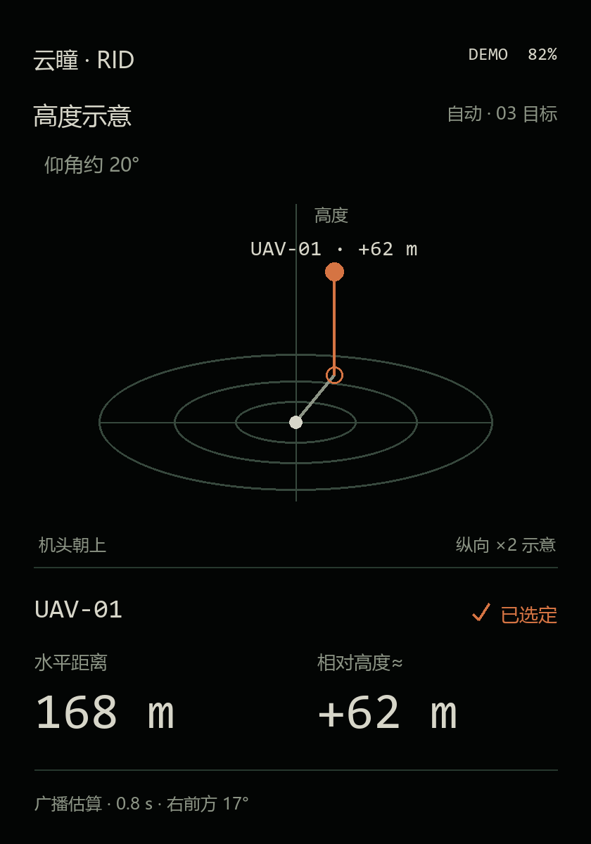
hardware/rid-handheld-id-a1/assets/screen-height.png
