66wyx/yuntong-roadshow/hardware/rid-handheld-id-a1/assets/screen-radar.png

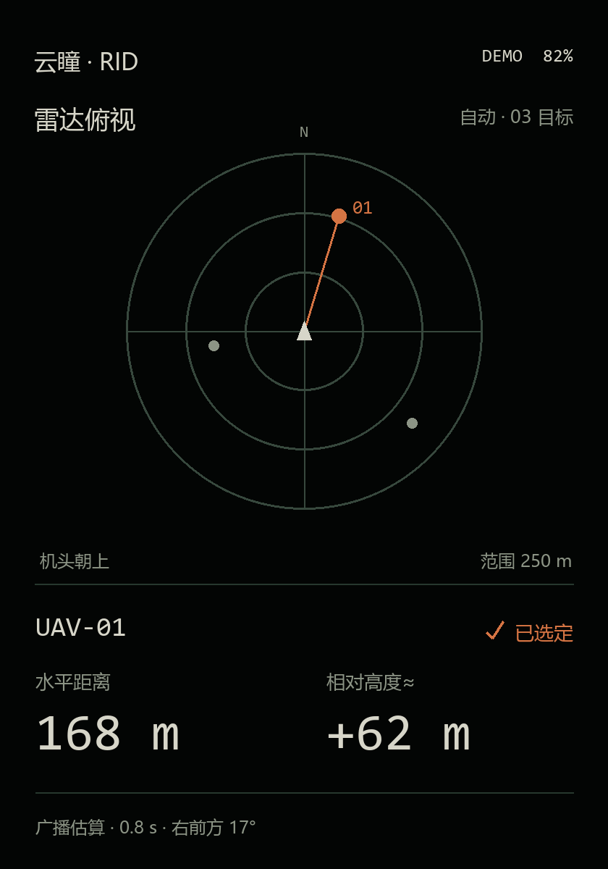
hardware/rid-handheld-id-a1/assets/screen-radar.png
