66wyx/yuntong-roadshow/hardware/rid-handheld-id-a1/assets/screen-reference.png

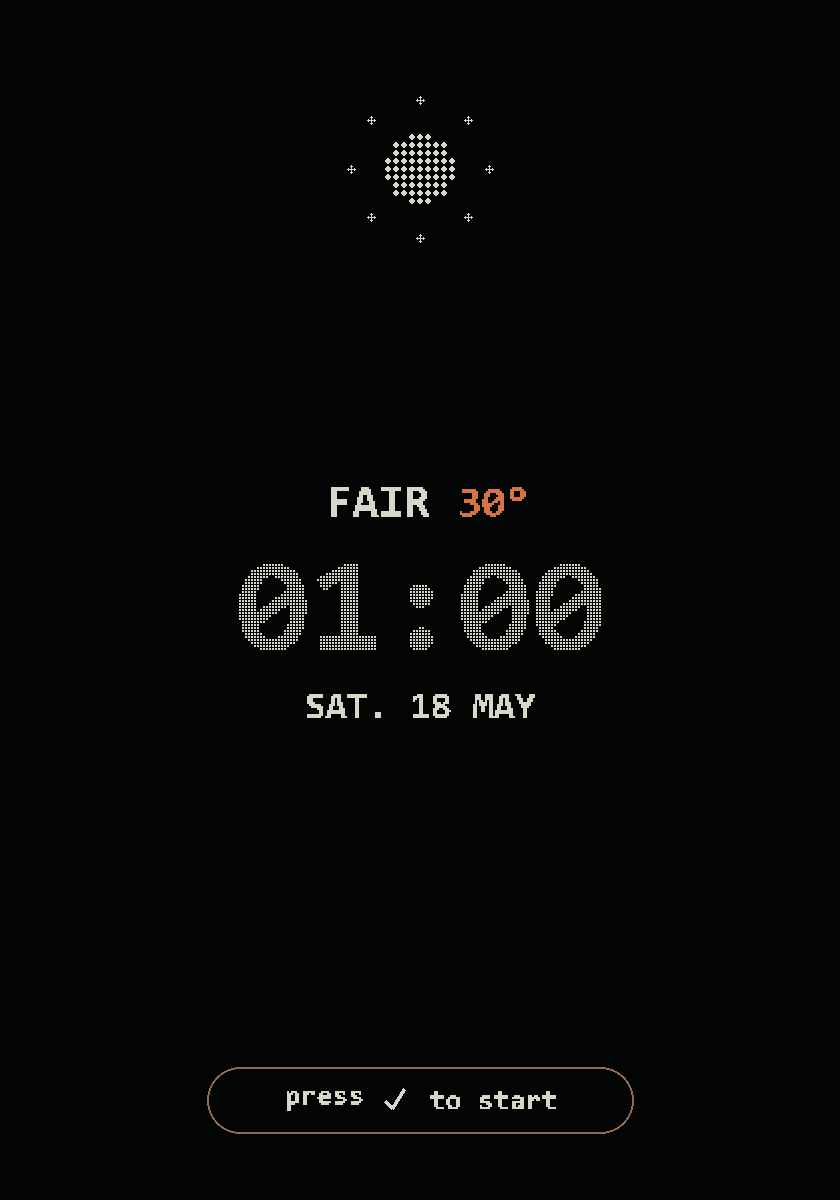
hardware/rid-handheld-id-a1/assets/screen-reference.png
