66wyx/yuntong-roadshow/hardware/rid-handheld-id-a1/renders/01-front-rid.png

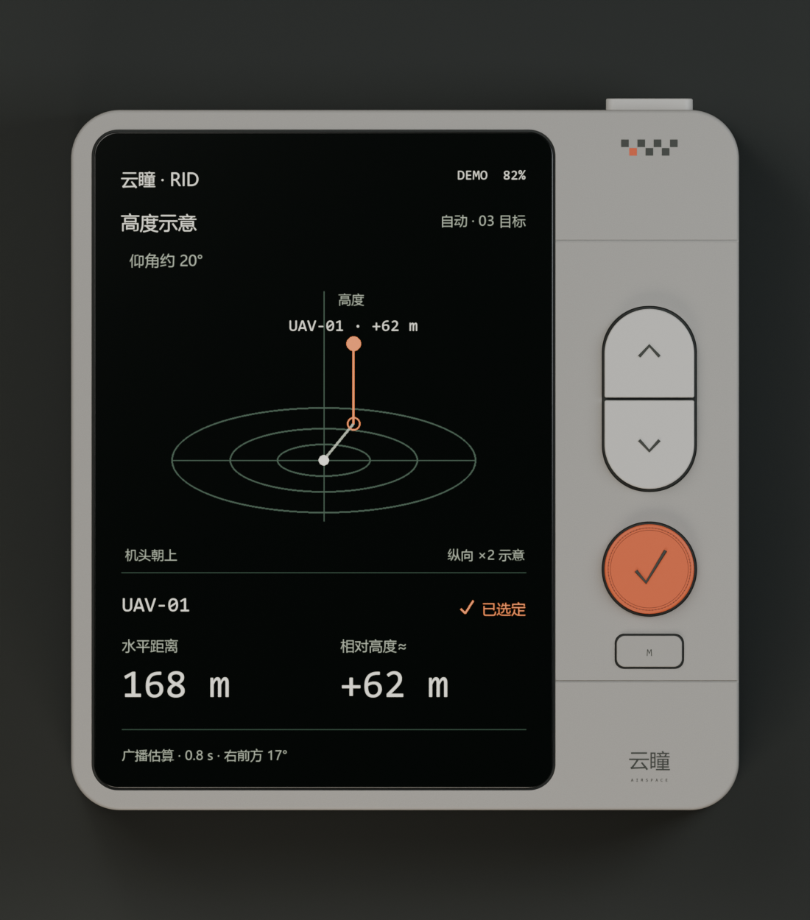
hardware/rid-handheld-id-a1/renders/01-front-rid.png
