66wyx/yuntong-roadshow/hardware/rid-handheld-id-a1/renders/03-reference-study.png

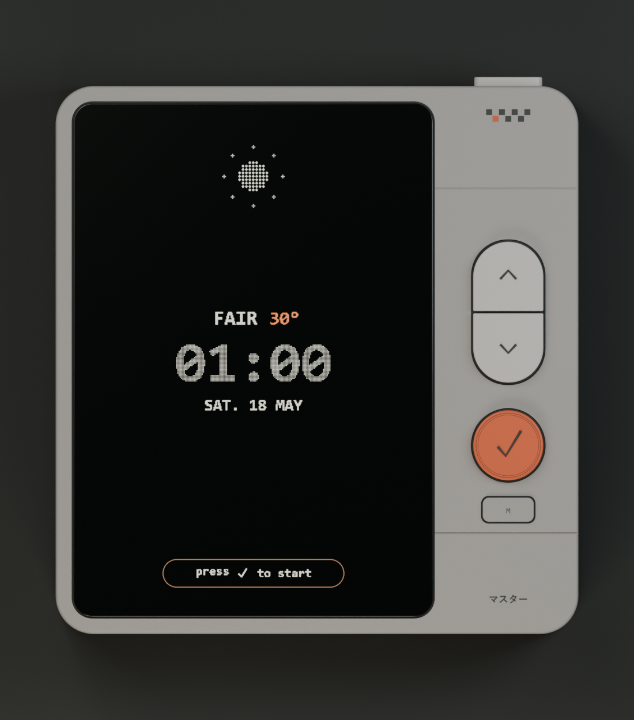
hardware/rid-handheld-id-a1/renders/03-reference-study.png
