66wyx/yuntong-roadshow/hardware/rid-handheld-id-a1/renders/04-controls-detail.png

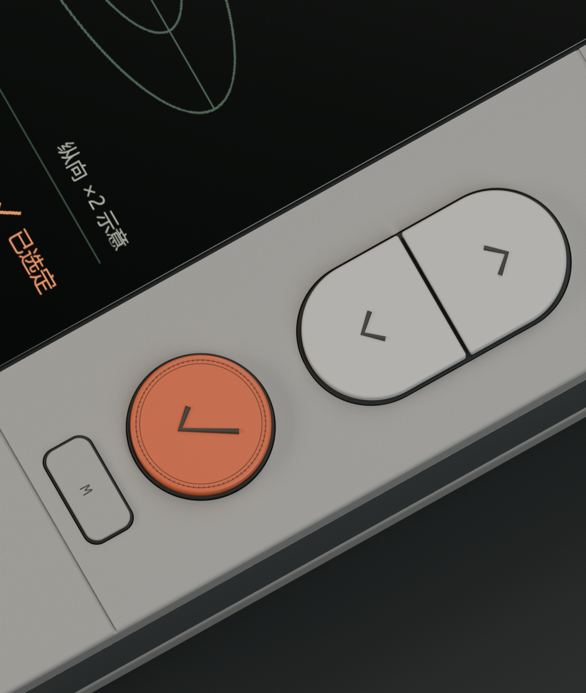
hardware/rid-handheld-id-a1/renders/04-controls-detail.png
