66wyx/yuntong-roadshow/hardware/rid-handheld-id-a1/renders/05-usbc-detail.png

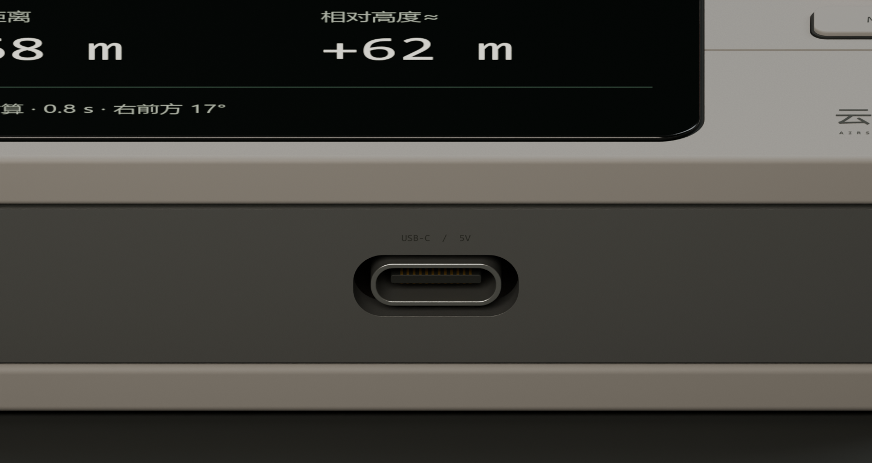
hardware/rid-handheld-id-a1/renders/05-usbc-detail.png
