66wyx/yuntong-roadshow/hardware/rid-handheld-id-a1/renders/06-rear.png

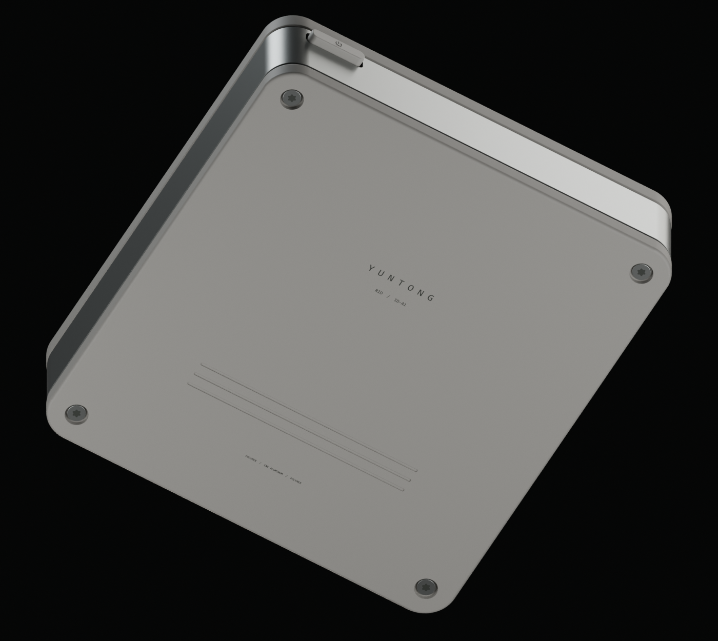
hardware/rid-handheld-id-a1/renders/06-rear.png
