66wyx/yuntong-roadshow/hardware/rid-handheld-id-a1/renders/07-exploded.png

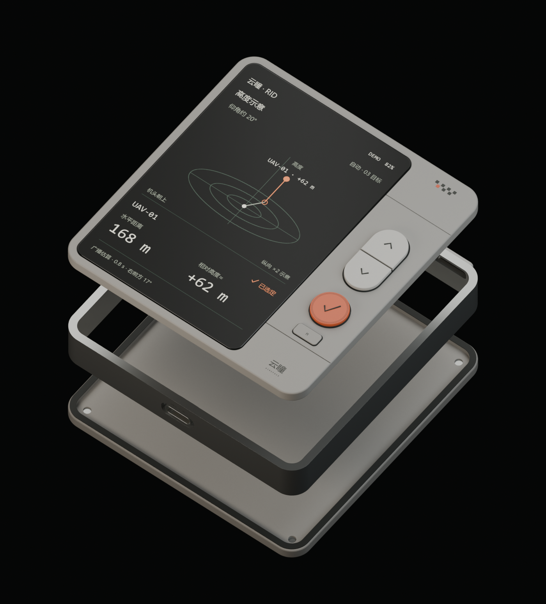
hardware/rid-handheld-id-a1/renders/07-exploded.png
