66wyx/yuntong-roadshow/hardware/rid-handheld-id-a1/renders/09-detail-board.png

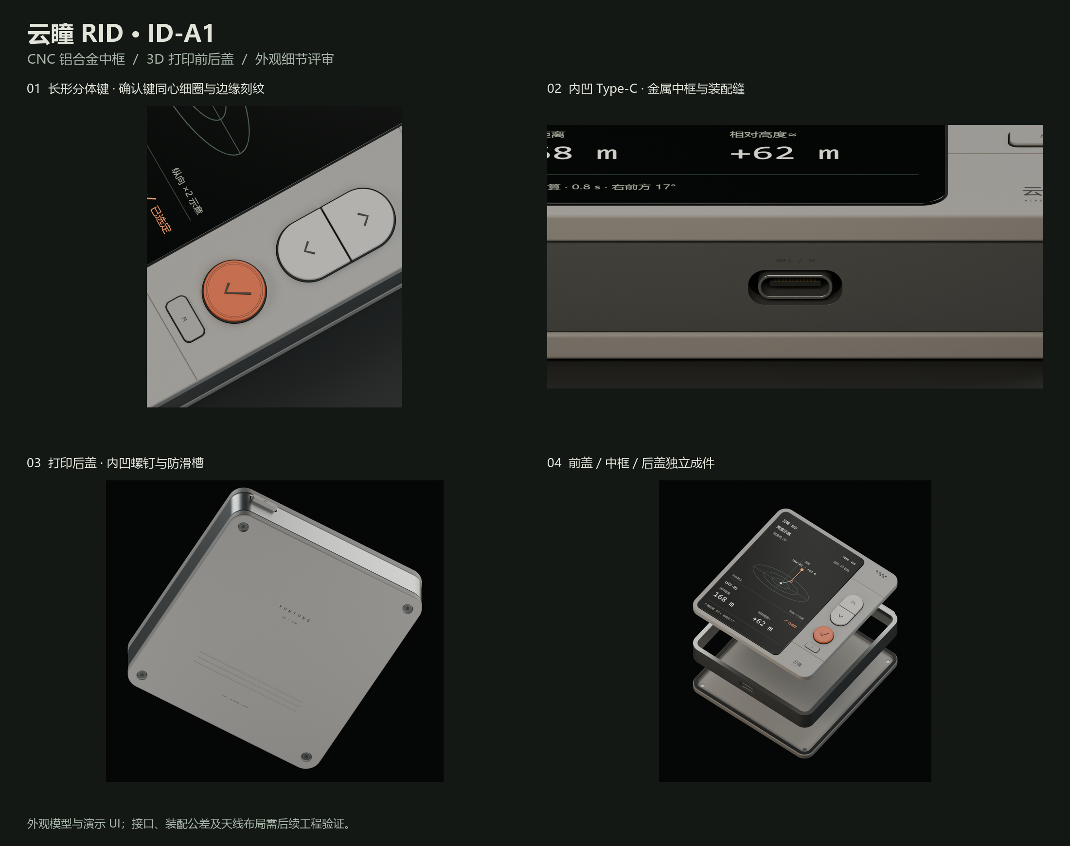
hardware/rid-handheld-id-a1/renders/09-detail-board.png
