66wyx/yuntong-roadshow/hardware/rid-handheld-id-a1/renders/10-reference-and-rid.png

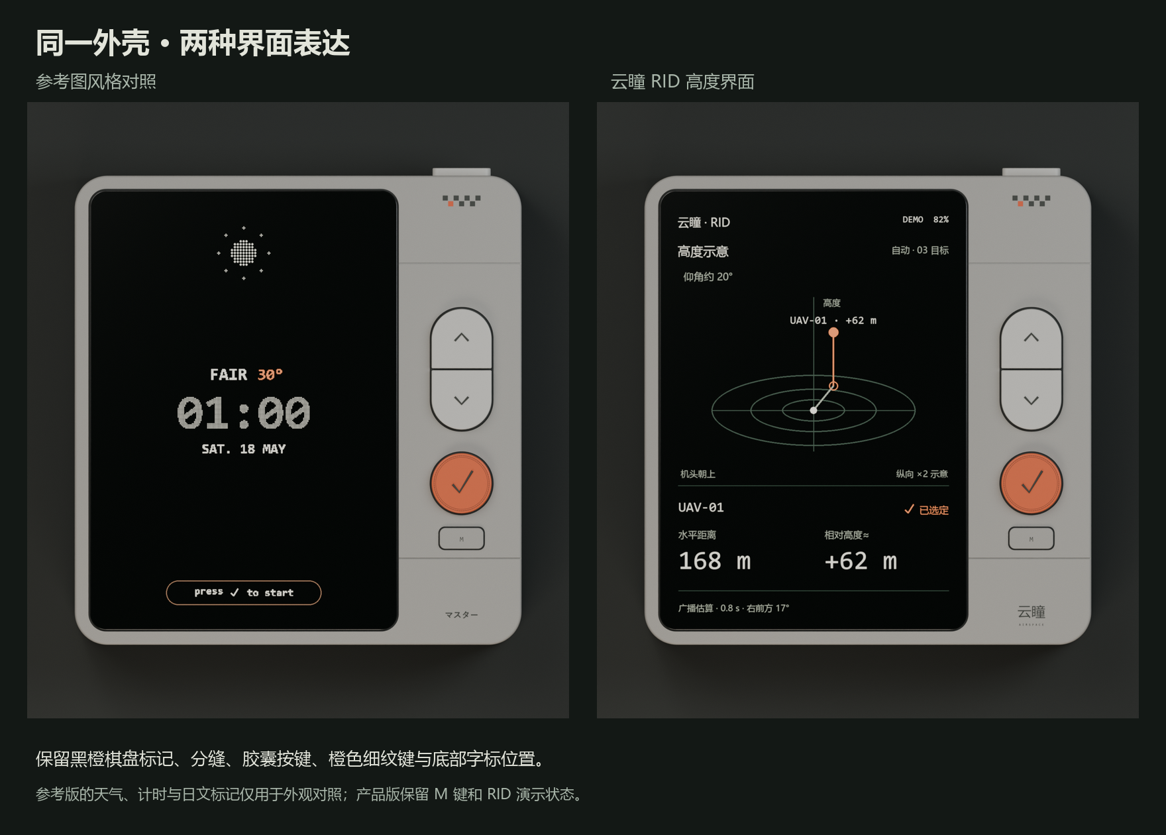
hardware/rid-handheld-id-a1/renders/10-reference-and-rid.png
