66wyx/yuntong-roadshow/hardware/rid-handheld-id-a2/assets/reference-metal-wrap.png

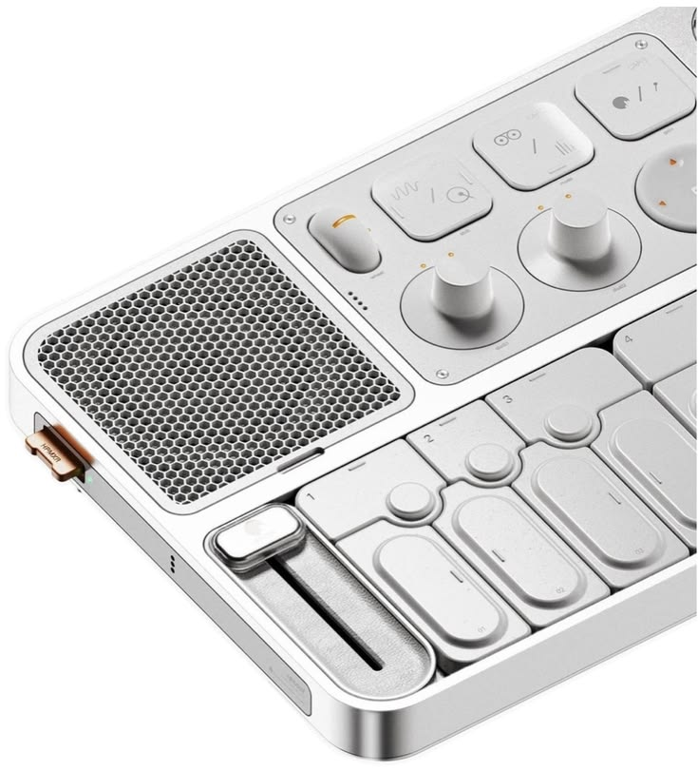
hardware/rid-handheld-id-a2/assets/reference-metal-wrap.png
