66wyx/yuntong-roadshow/hardware/rid-handheld-id-a2/assets/reference-original.png

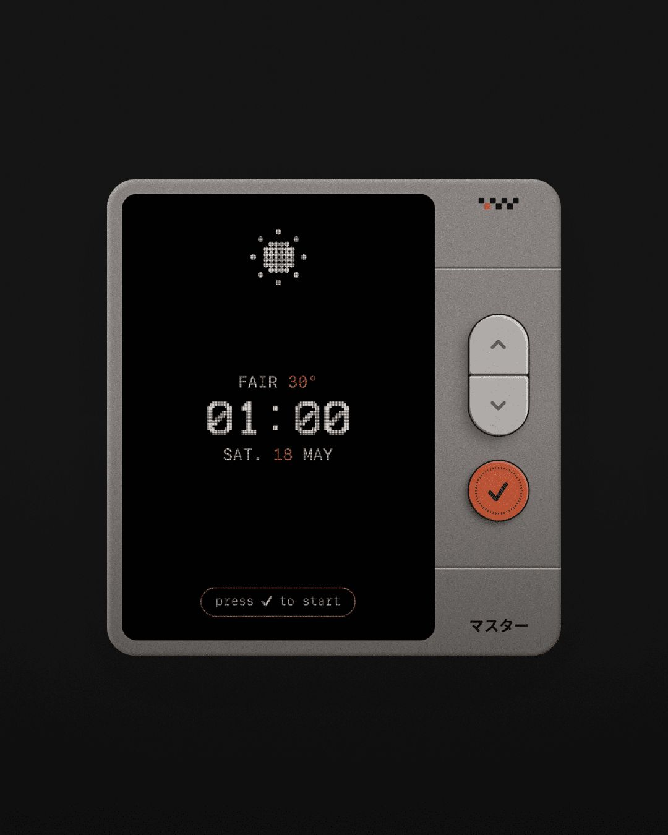
hardware/rid-handheld-id-a2/assets/reference-original.png
