66wyx/yuntong-roadshow/hardware/rid-handheld-id-a2/assets/screen-radar-460.png

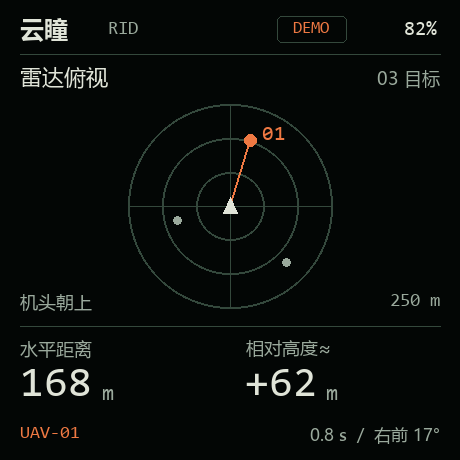
hardware/rid-handheld-id-a2/assets/screen-radar-460.png
