66wyx/yuntong-roadshow/hardware/rid-handheld-id-a2/renders/02-front-height.png

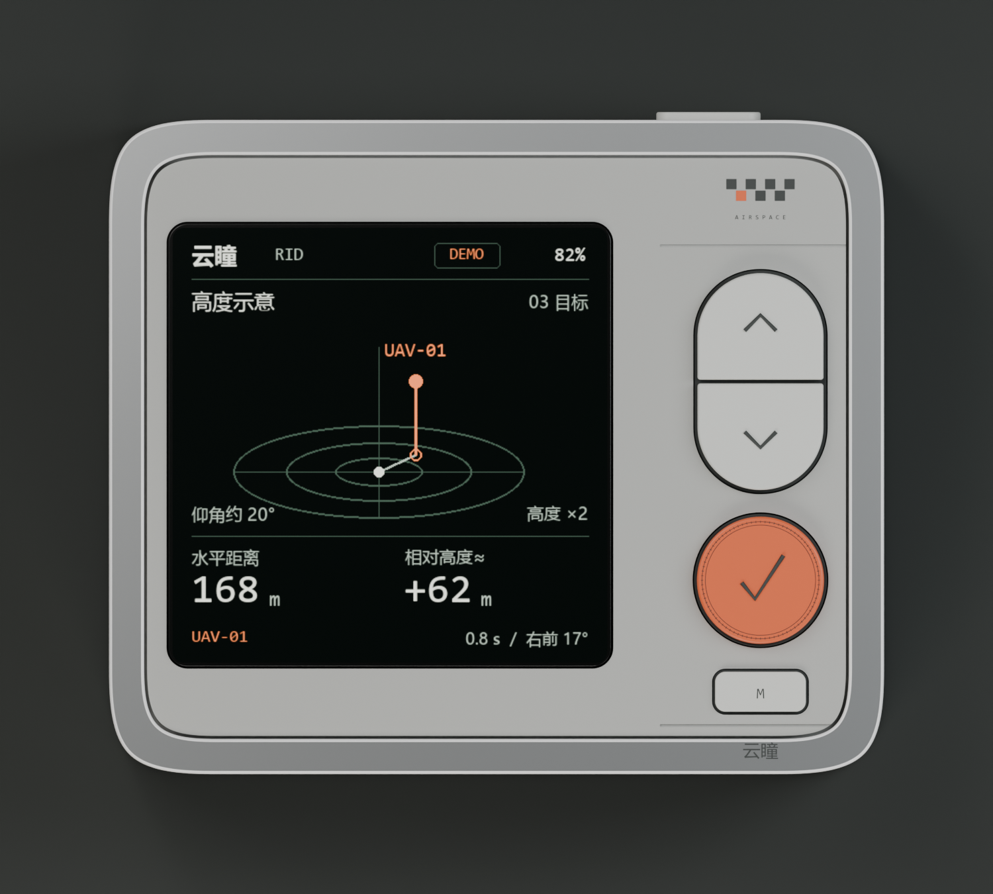
hardware/rid-handheld-id-a2/renders/02-front-height.png
