66wyx/yuntong-roadshow/hardware/rid-handheld-id-a2/renders/04-continuous-corner.png

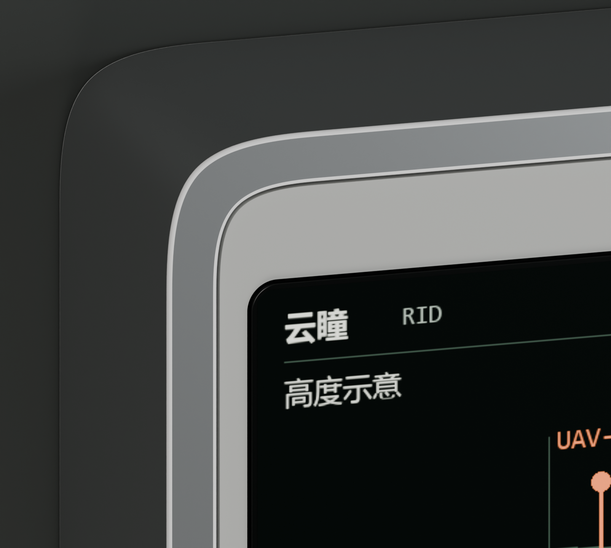
hardware/rid-handheld-id-a2/renders/04-continuous-corner.png
