66wyx/yuntong-roadshow/hardware/rid-handheld-id-a2/renders/05-controls.png

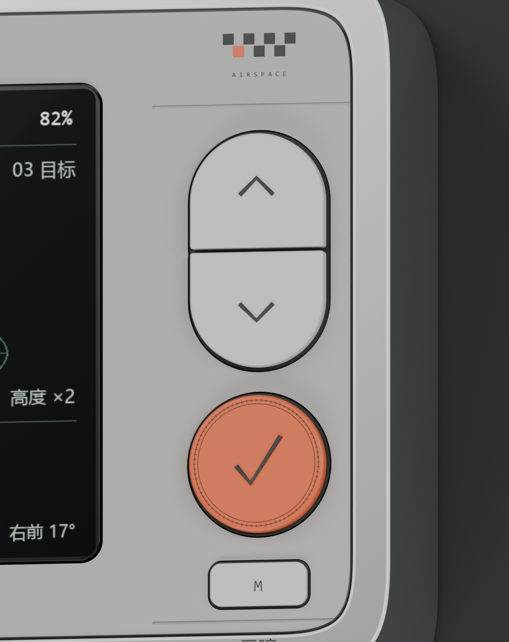
hardware/rid-handheld-id-a2/renders/05-controls.png
