66wyx/yuntong-roadshow/hardware/rid-handheld-id-a2/renders/06-usb-c.png

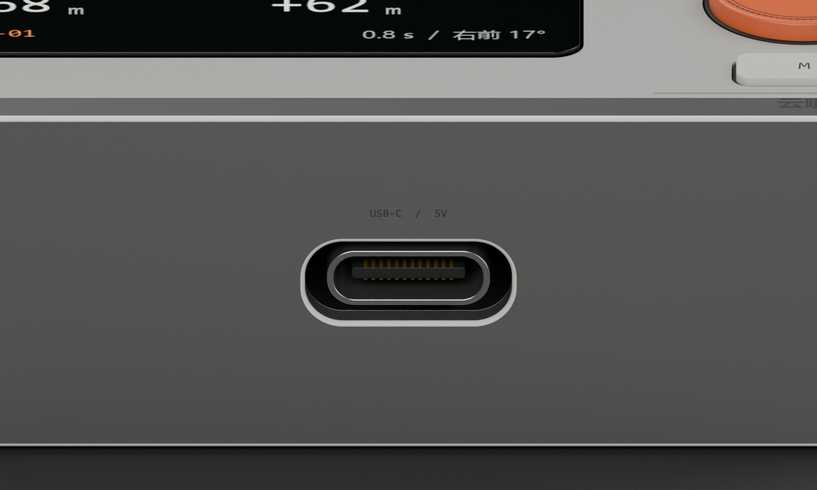
hardware/rid-handheld-id-a2/renders/06-usb-c.png
