66wyx/yuntong-roadshow/hardware/rid-handheld-id-a2/renders/07-inset-rear.png

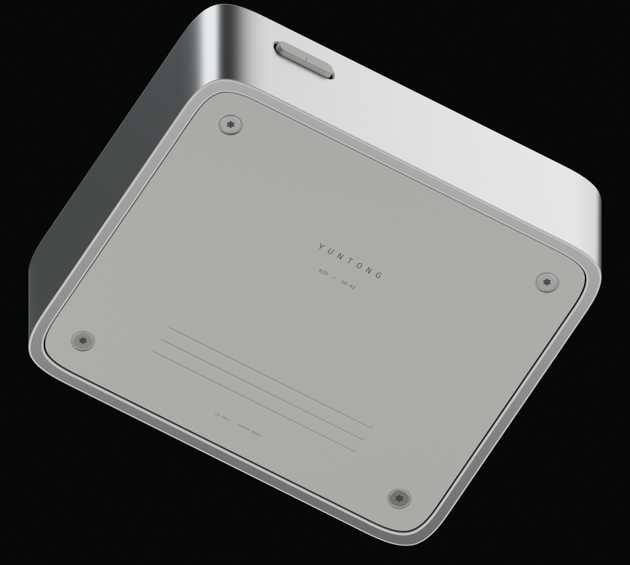
hardware/rid-handheld-id-a2/renders/07-inset-rear.png
