66wyx/yuntong-roadshow/hardware/rid-handheld-id-a2/renders/08-exploded.png

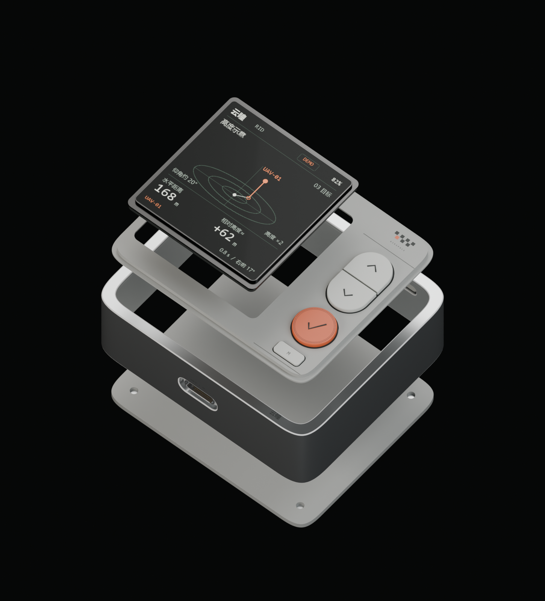
hardware/rid-handheld-id-a2/renders/08-exploded.png
