66wyx/yuntong-roadshow/hardware/rid-handheld-id-a2/renders/09-continuous-shell.png

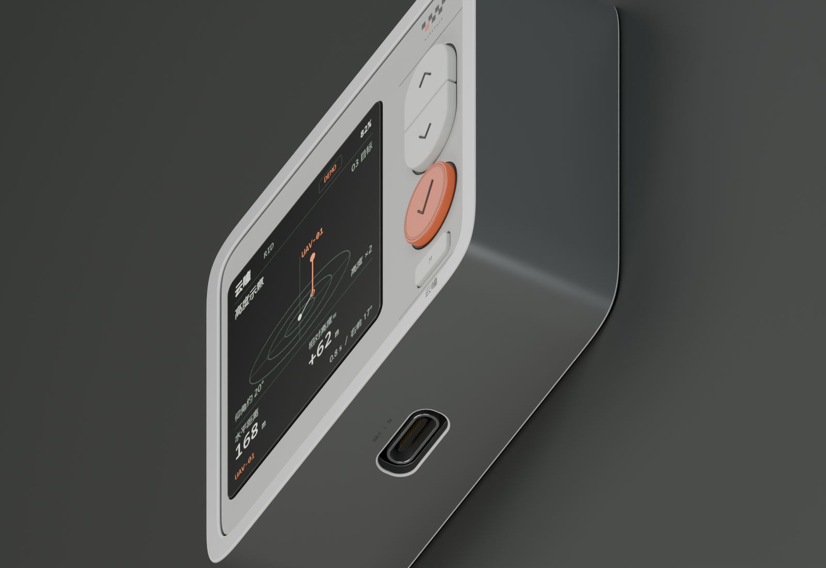
hardware/rid-handheld-id-a2/renders/09-continuous-shell.png
