66wyx/yuntong-roadshow/hardware/rid-handheld-id-a2/renders/10-design-board.png

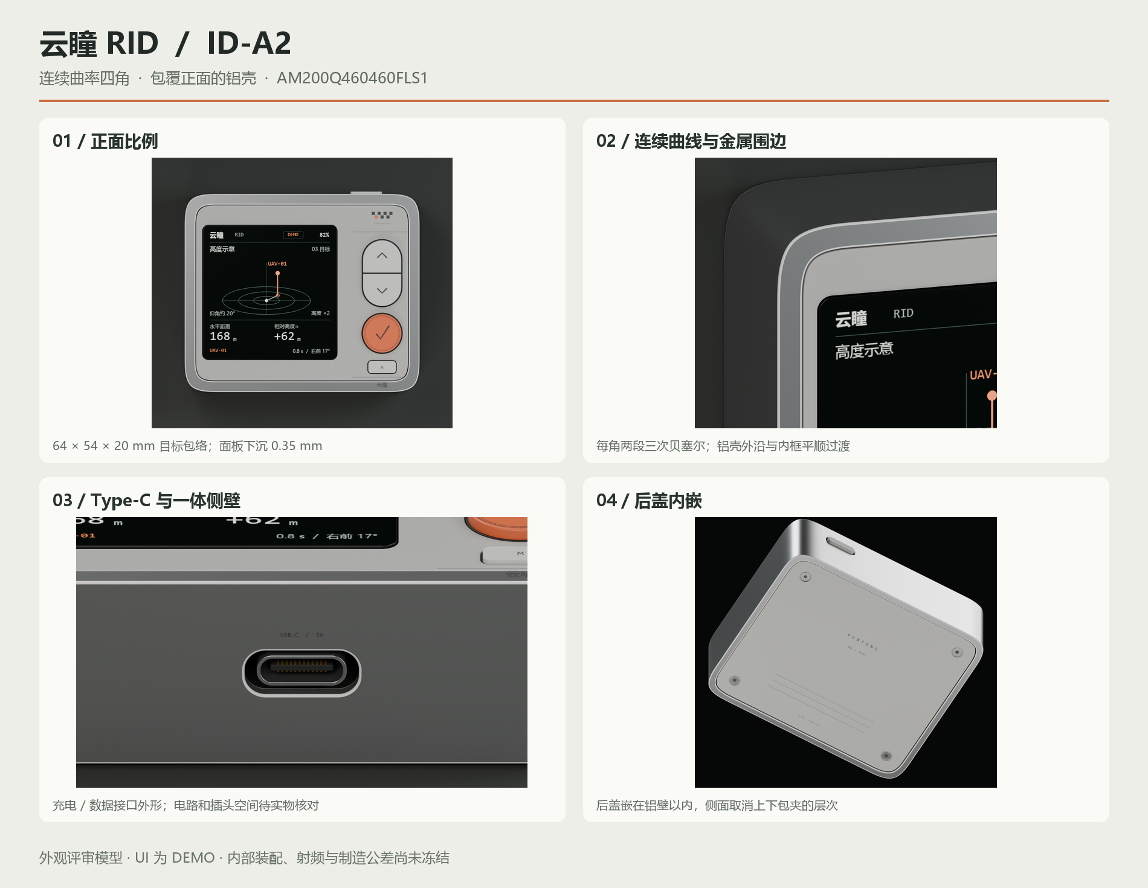
hardware/rid-handheld-id-a2/renders/10-design-board.png
