66wyx/yuntong-roadshow/site/projects/ams-asm/assets/ai/selected/concept-a.webp

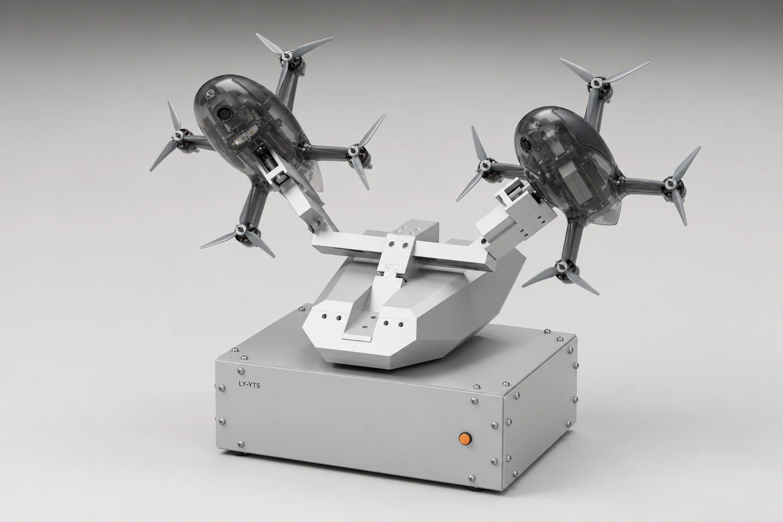
site/projects/ams-asm/assets/ai/selected/concept-a.webp
