66wyx/yuntong-roadshow/site/projects/ams-asm/assets/media/campus-sensing.webp

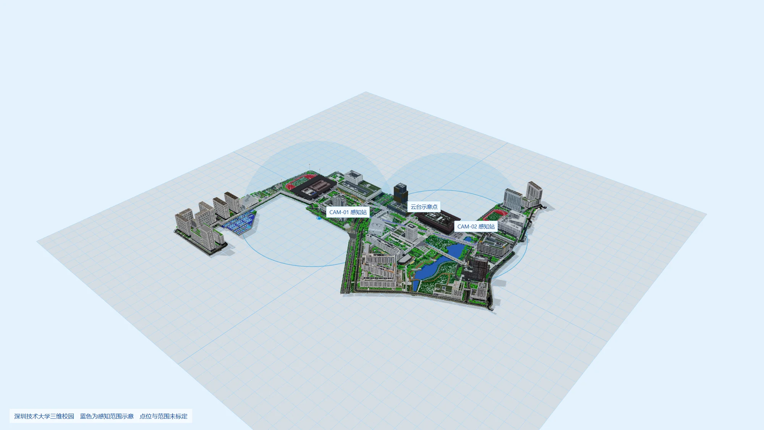
site/projects/ams-asm/assets/media/campus-sensing.webp
