66wyx/yuntong-roadshow/site/projects/ams-asm/assets/media/diu-solicitation.webp

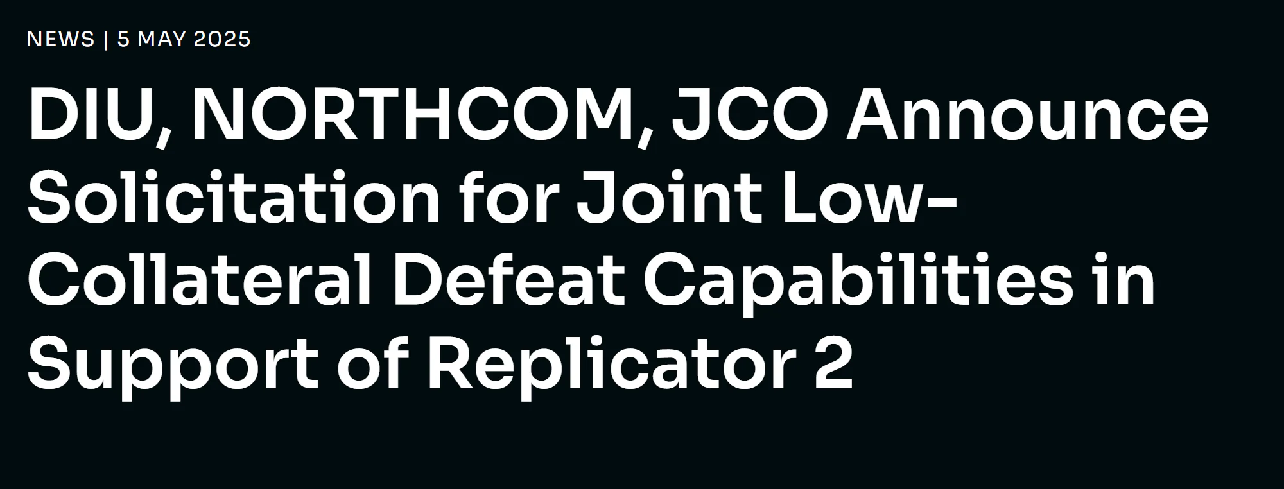
site/projects/ams-asm/assets/media/diu-solicitation.webp
