66wyx/yuntong-roadshow/site/projects/ams-asm/assets/media/embassy-statement.webp

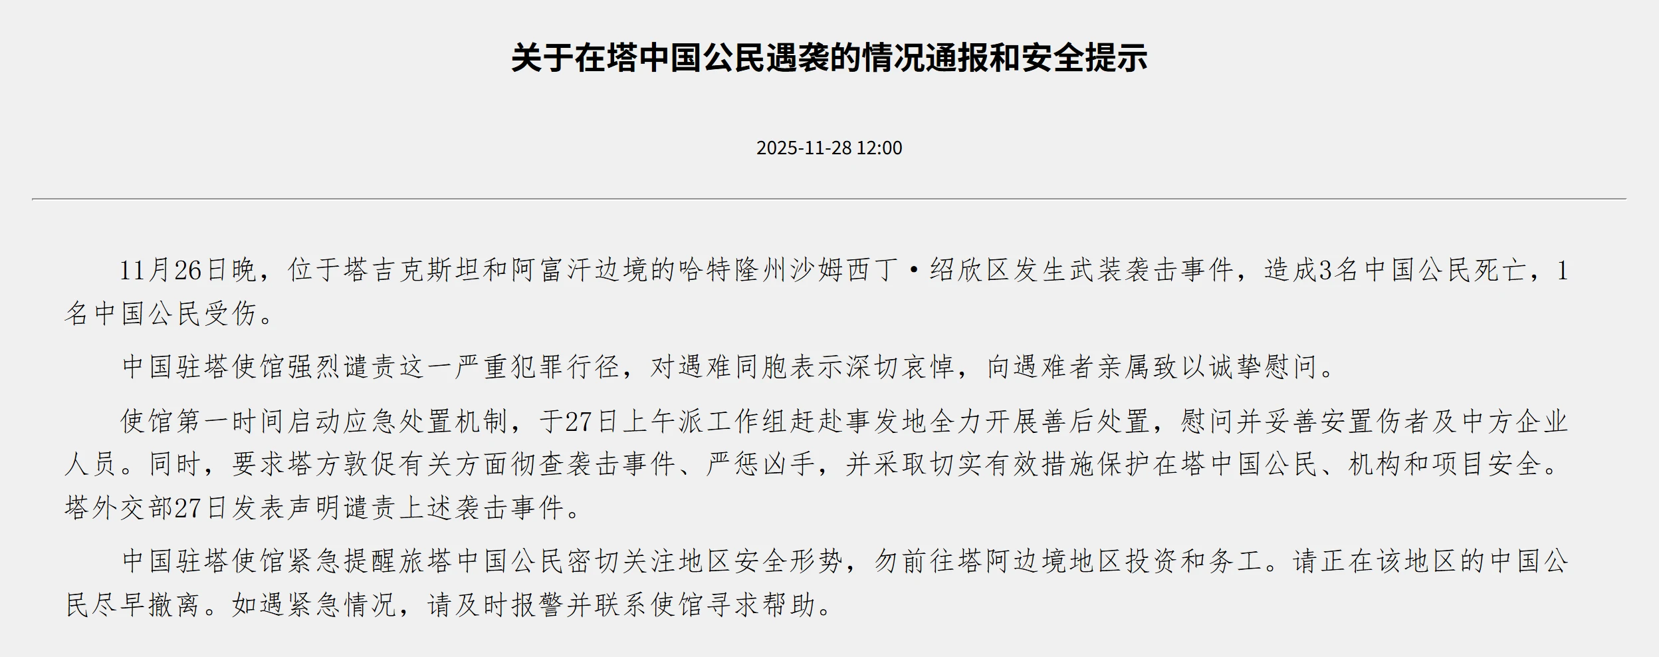
site/projects/ams-asm/assets/media/embassy-statement.webp
