66wyx/yuntong-roadshow/site/projects/ams-asm/assets/media/fibre-spool.webp

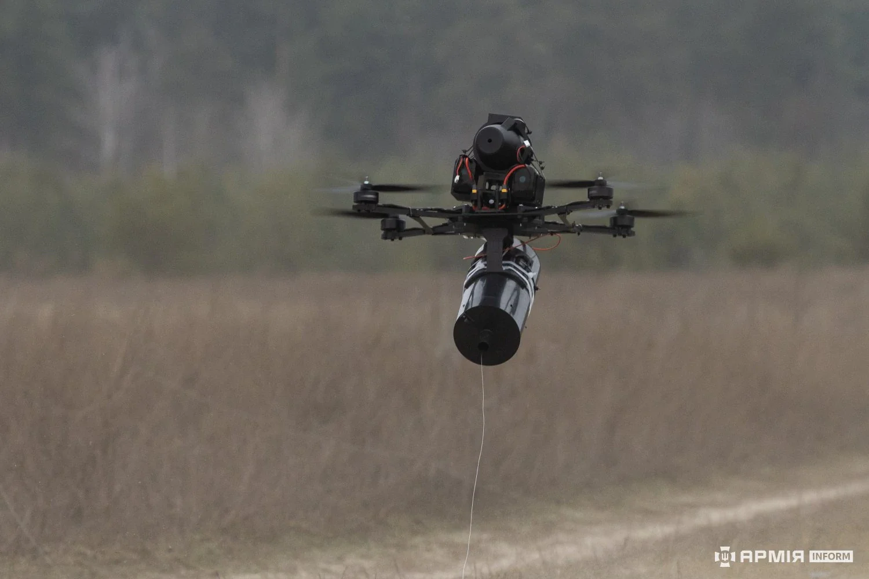
site/projects/ams-asm/assets/media/fibre-spool.webp
