66wyx/yuntong-roadshow/site/projects/ams-asm/assets/reference/explode-02-full.png

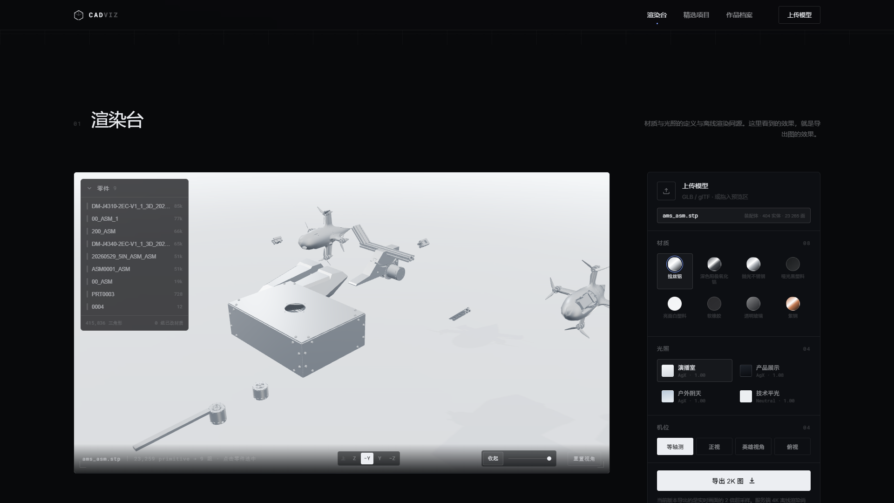
site/projects/ams-asm/assets/reference/explode-02-full.png
