66wyx/yuntong-roadshow/site/projects/ams-asm/assets/reference/tree-03-selected.png

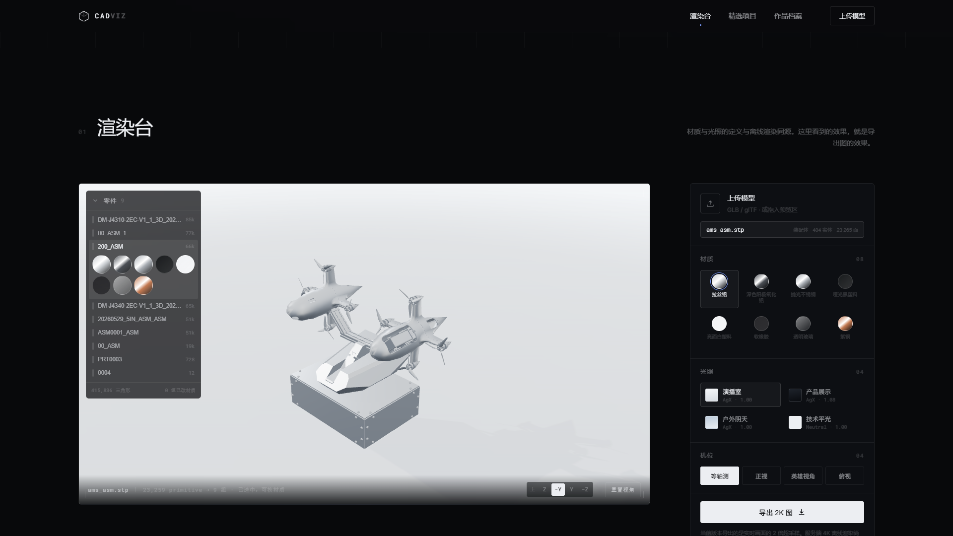
site/projects/ams-asm/assets/reference/tree-03-selected.png
