66wyx/yuntong-roadshow/site/projects/ams-asm/assets/render/hero-desert-wide.webp

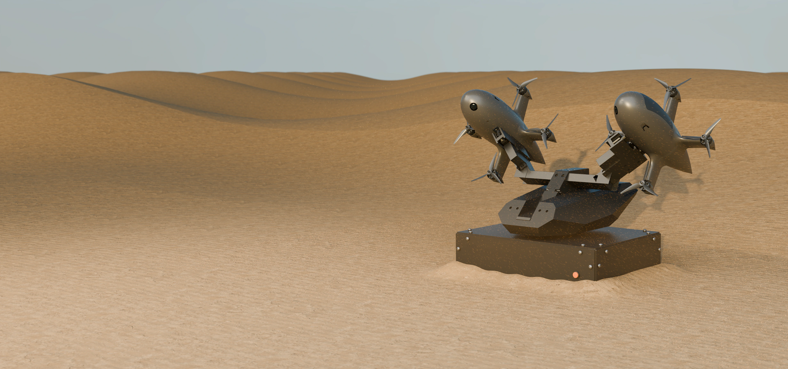
site/projects/ams-asm/assets/render/hero-desert-wide.webp
