66wyx/yuntong-roadshow/site/projects/ams-asm/assets/render/hero-studio-transparent.webp

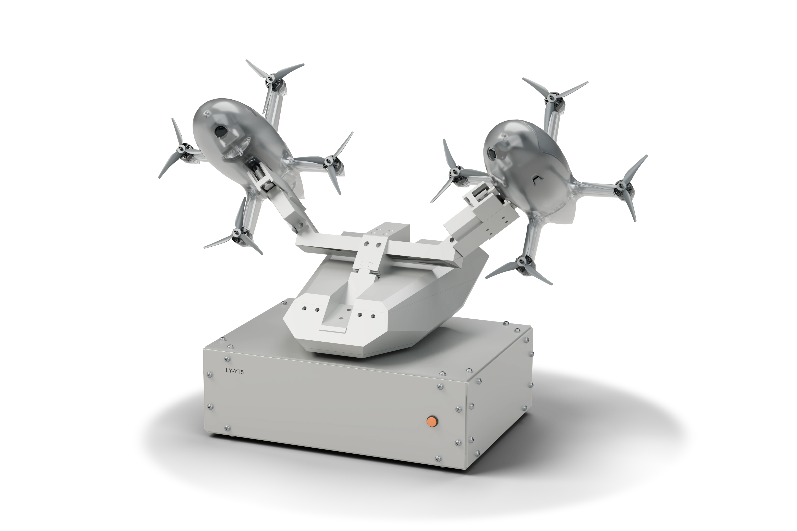
site/projects/ams-asm/assets/render/hero-studio-transparent.webp
