66wyx/yuntong-roadshow/site/projects/ams-asm/assets/render/product-structure.webp

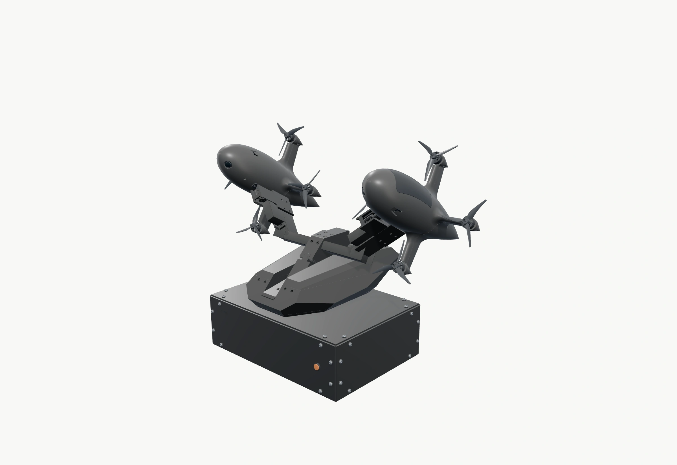
site/projects/ams-asm/assets/render/product-structure.webp
