66wyx/yuntong-roadshow/hardware/rid-handheld-evt1/mechanical/generated/component-placement.png

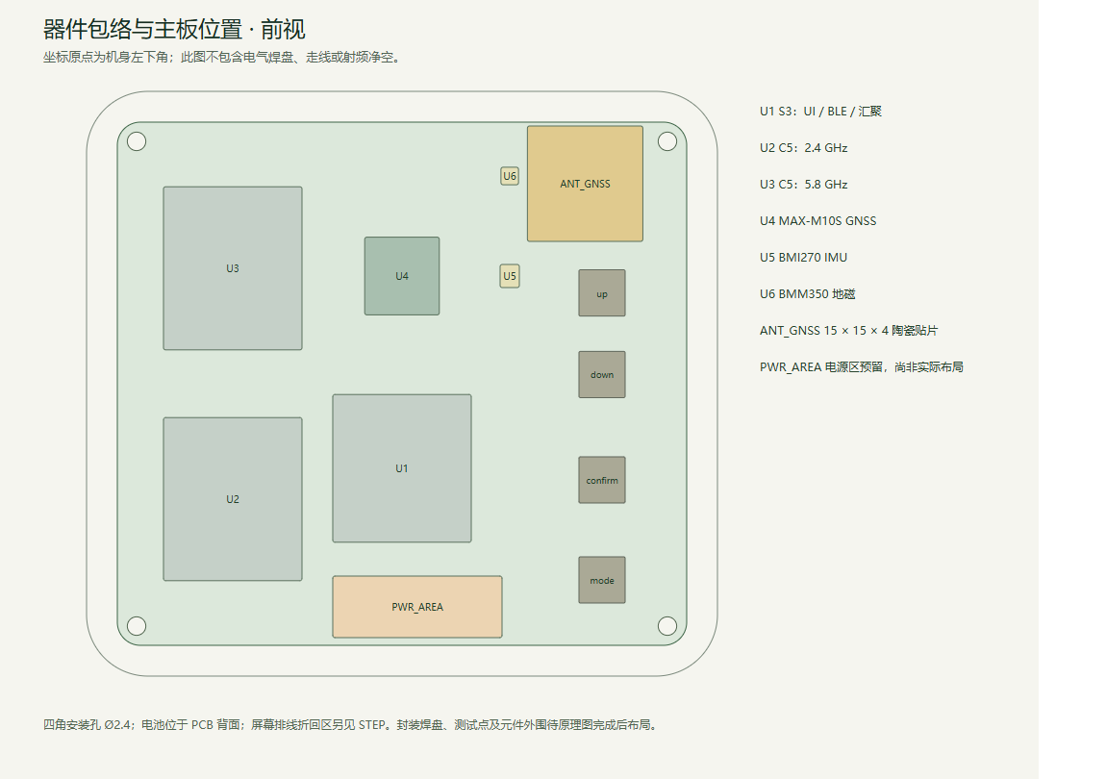
hardware/rid-handheld-evt1/mechanical/generated/component-placement.png
