66wyx/yuntong-roadshow/(list of files, cad)

Other CAD files:
hardware/rid-handheld-evt1/mechanical/generated/rid-handheld-evt1-a0.step
hardware/rid-handheld-evt1/mechanical/generated/front_shell_fit_prototype.stl
hardware/rid-handheld-evt1/mechanical/generated/key_mode_fit_prototype.stl
hardware/rid-handheld-evt1/mechanical/generated/key_down_fit_prototype.stl
hardware/rid-handheld-evt1/mechanical/generated/key_confirm_fit_prototype.stl
hardware/rid-handheld-evt1/mechanical/generated/key_up_fit_prototype.stl
hardware/rid-handheld-evt1/mechanical/generated/display_cradle_fit_prototype.stl
hardware/rid-handheld-evt1/mechanical/generated/rear_shell_fit_prototype.stl
hardware/rid-handheld-id-a1/blender/yuntong-rid-id-a1.blend
hardware/rid-handheld-id-a2/blender/yuntong-rid-id-a2.blend
