66wyx/yuntong-roadshow/hardware/rid-handheld-evt1/mechanical/generated/assembly-view.png

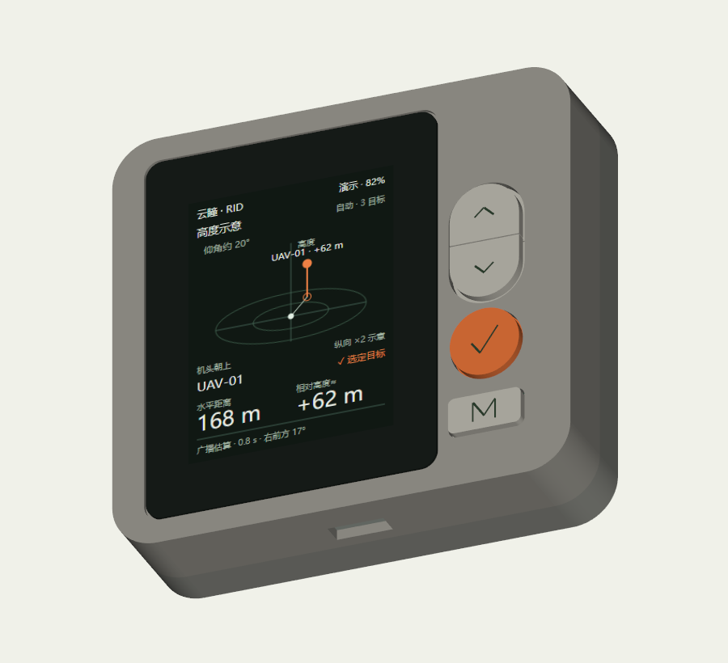
hardware/rid-handheld-evt1/mechanical/generated/assembly-view.png
