66wyx/yuntong-roadshow/hardware/rid-handheld-evt1/validation/BRINGUP.md

**首台样机验证表 · 全部待实机执行**

本表没有预先填写通过结论。主机逻辑测试和 CAD 检查见 `validation-report.json`，不能替代以下实测。

| 顺序 | 实测与记录 | 通过条件 / 输出 |
|---|---|---|
| 0 | 供应商屏幕 IM0/IM1、FPC 方向/弯折、电池最大外形、GNSS 天线载板、USB 精确订货号 | 数据手册与实物一致，修订结构和 BOM |
| 1 | 详细原理图、所有电压域、电流预算、USB/电池保护、关机反灌、ERC | 评审记录完整；完成 PCB 铜箔、DRC 与装配图后生成制造包 |
| 2 | 限流供电，先不上电池；各轨电压、短路、静态/启动电流 | 无异常电流；S3 USB/UART 下载与独立恢复可用 |
| 3 | Flash/PSRAM；双 C5 独立下载、复位、UART 帧和断帧恢复 | 各模块可定位故障，日志不污染数据帧 |
| 4 | LCD 真实供应商序列、背光 0–100%、全部按键与长按 | 两种 UI 可读；无误触/连击；确认屏幕 FPC 不受壳体挤压 |
| 5 | 本机 GNSS；两种姿态及握持遮挡；IMU/罗盘轴向、整机标定 | 与参考方向/位置记录对照；异常有降级提示 |
| 6 | 已知样本的 BLE / Wi-Fi 2.4 / Wi-Fi 5.8 分别接收与解码 | 原始包和逐字段解码对照，记录实际 PHY/信道；未测能力单独标明 |
| 7 | ASTM/OpenDroneID 与 GB 46750-2025 独立样本集 | 坐标、时间、位置类型、高度基准均可追溯；不能用一种通过代替另一种 |
| 8 | 三路同时运行；测不同广播速率/信道的漏包、丢队列、串口时延 | 获得实际覆盖范围与性能表；确认调度策略 |
| 9 | USB A-to-C / C-to-C、正反插、低电插拔、边用边充、关机充电 | 按电源政策限流；满电/空闲/温度故障可区分；接收连续性有记录 |
| 10 | 最大背光 + 三路接收 + 充电，温升/电压纹波/罗盘偏移 | 在器件/电池额定范围，记录降额或修改项 |
| 11 | 打印装配、螺钉/键程、USB 插拔、线束、跌落前后定位与接收 | 电池不受压，按键回弹可靠；用户握持与接口间隙可用 |
| 12 | 室外规定路线、平放/竖持、续航至受控关机与重启 | 发布实测续航、误差和限制；修订 EVT1-A1 |

记录模板：日期 / 硬件版本 / 固件提交与 IDF 版本 / 电池与天线料号 / 测试条件 / 原始日志路径 / 结果 / 问题 / 修订。相对高度只有双方高度采用相同基准且有效时才显示；室内回放必须始终标“演示”。
