66wyx/yuntong-roadshow/(commit log)

2026-11-05 test(rid): retain EVT0 display and decoder validation prototypes
2026-11-05 fix(rid): correct P4 decoding and redesign the receiver UI
    Decoder and geometry
    - ASTM track no longer overflows uint8_t; westerly tracks decoded wrong.
    - Relative height is target geodetic altitude minus receiver altitude
    (rid_geo); the broadcast take-off height is no longer shown as relative.
    - Operator ID is kept separate from the aircraft UAS ID.
    - Validity flags for altitude, height, track and speed.
    - wait_cmd_response ignores late replies to earlier commands.
    UI
    - New portable renderer (rid_gfx): anti-aliased rings, lines, arcs,
    rounded rects and 4-bit text into the RGB565 framebuffer. Replaces the
    broken ellipse routine that drew circles as tall ovals.
    - Redesigned north-up pl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
2026-11-05 feat(rid): Windows Wi-Fi Direct RID transmitter and bench channel options
    Transmitter
    - windows_wfd_tx.py: adds the RID vendor element to a Windows Wi-Fi Direct
    group owner's Beacons via pywinrt; same path/identity options as
    virtual_rid_tx.py. No VM, monitor mode or admin rights needed.
    - P2P listen state disabled: otherwise the radio leaves the GO channel and
    Beacons arrive in 3-frame bursts every ~3 s.
    - Waits for the previous publisher to stop before restarting.
    Receiver (P4)
    - CONFIG_RID_CAPTURE_CHANNEL (default 6); the tested GO uses channel 11.
    - CONFIG_RID_SCAN_DWELL_MS hops 1/6/11 to locate an unknown source.
    - CONFIG_RID_DEBUG_WATCH_MAC logs every management frame from one M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
